CMU-CREATE-Lab/breathecam_v4/CAD/pi_cam/testing/lockring.jpg

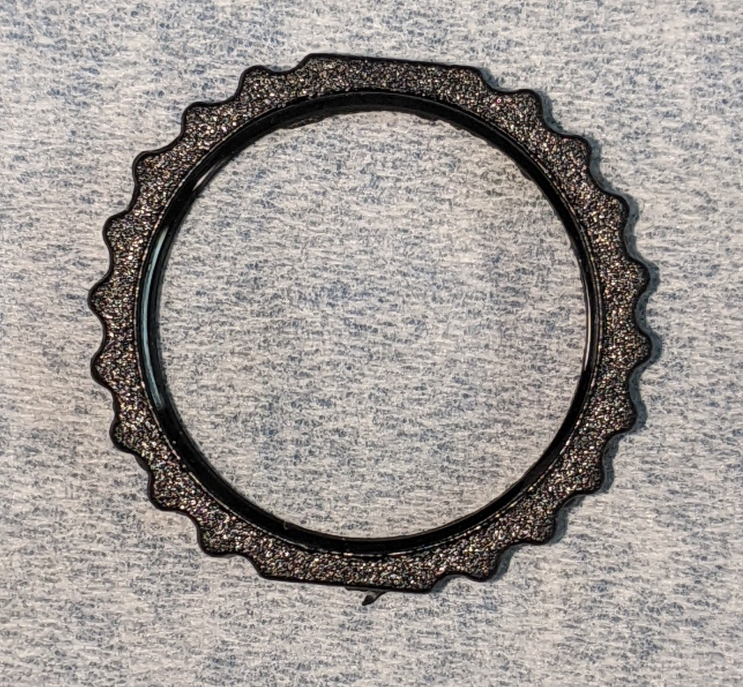
CAD/pi_cam/testing/lockring.jpg
