CMU-CREATE-Lab/breathecam_v4/README.md

See Code/pi_cam/notes.txt for info on installing and building software.
