CMU-CREATE-Lab/breathecam_v4/CAD/pi_cam/brackets/pole_clamp_assem.SLDASM

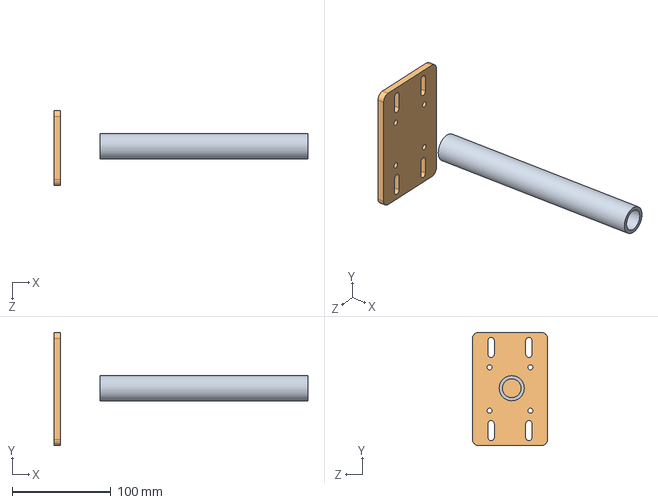
[picture p2: CAD file, 2024-10-29]
CAD/pi_cam/brackets/pole_clamp_assem.SLDASM
256.7 x 114.3 x 76.2 mm
pole_clamp_plate
dual_mount_horizontal_tube
