CMU-CREATE-Lab/breathecam_v4/CAD/pi_cam/testing/focus_adapter_14mm_assem.SLDASM

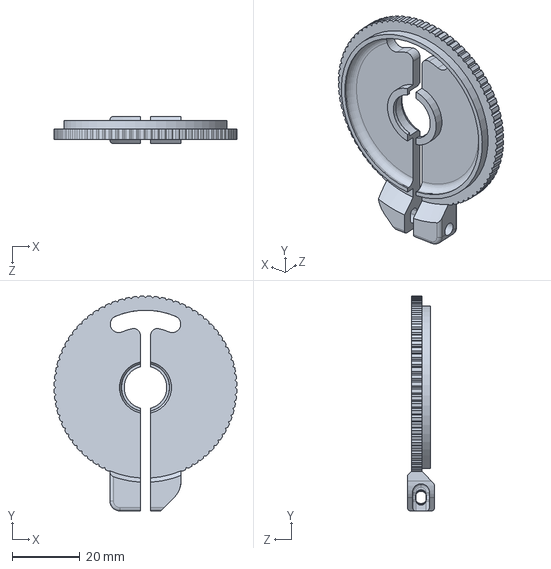
[picture p3: CAD file, 2024-01-23]
CAD/pi_cam/testing/focus_adapter_14mm_assem.SLDASM
54.0 x 63.5 x 8.00 mm
