CMU-CREATE-Lab/breathecam_v4/CAD/pi_cam/angle_fix_assy.SLDASM

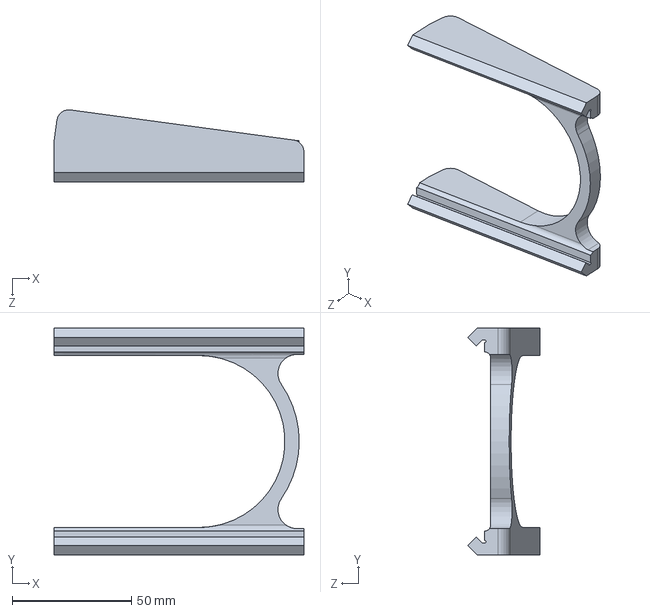
[picture p4: CAD file, 2023-10-27]
CAD/pi_cam/angle_fix_assy.SLDASM
104.8 x 95.0 x 30.3 mm
