CMU-CREATE-Lab/breathecam_v4/CAD/pi_cam/fan_assy.SLDASM

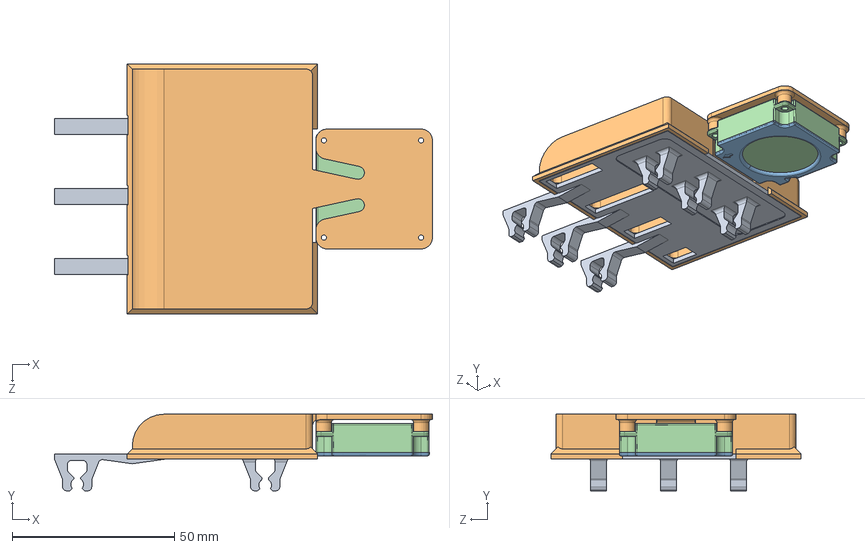
[picture p5: CAD file, 2023-10-27]
CAD/pi_cam/fan_assy.SLDASM
116.6 x 23.6 x 77.2 mm
air_box
air_top
410020620000_2.stp
3_5CM-FRAME_BEFORE__AF1.stp
