CMU-CREATE-Lab/breathecam_v4/CAD/pi_cam/brackets/flat_mount_plate_24in.SLDPRT

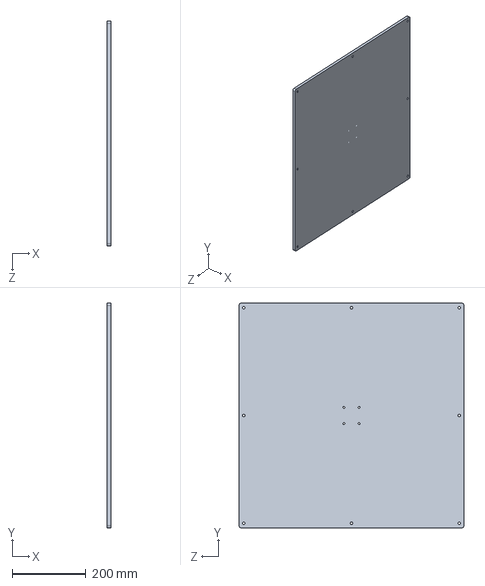
[picture p6: CAD file, 2025-08-26]
CAD/pi_cam/brackets/flat_mount_plate_24in.SLDPRT
9.53 x 609.6 x 609.6 mm
