CMU-CREATE-Lab/breathecam_v4/CAD/pi_cam/dummy_parts/CIL100-F3.6-M12ANIR.stp

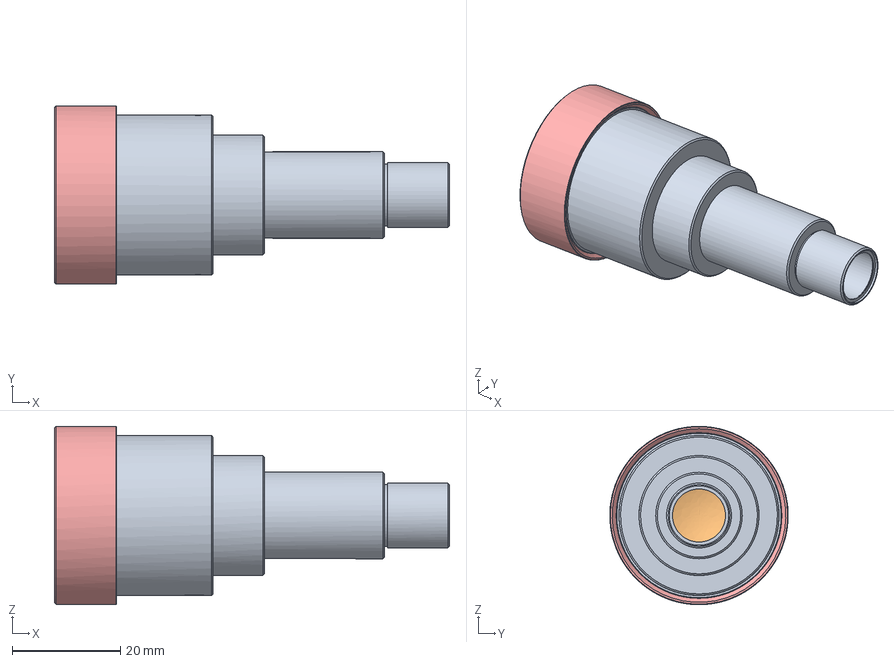
[picture p7: CAD file, 2026-09-17]
CAD/pi_cam/dummy_parts/CIL100-F3.6-M12ANIR.stp
73.0 x 33.0 x 33.0 mm
主镜筒
D-3
麦拉片
A
压圈
