CMU-CREATE-Lab/breathecam_v4/CAD/pi_cam/mount_plate_single.SLDPRT

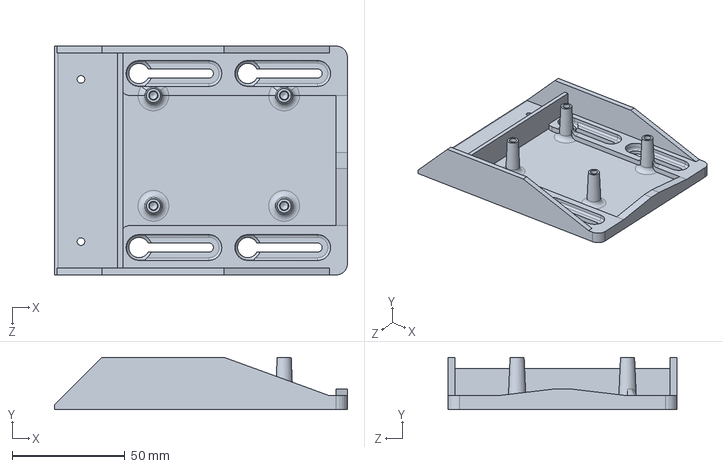
[picture p8: CAD file, 2026-09-17]
CAD/pi_cam/mount_plate_single.SLDPRT
130.0 x 23.2 x 101.6 mm
