CMU-CREATE-Lab/breathecam_v4/CAD/pi_cam/testing/focus_adapter_14mm_small.SLDPRT

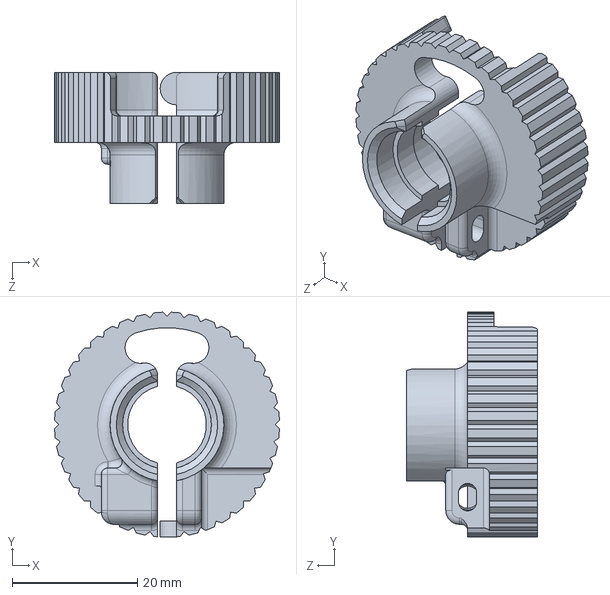
[picture p9: CAD file, 2024-10-29]
CAD/pi_cam/testing/focus_adapter_14mm_small.SLDPRT
36.0 x 35.9 x 21.0 mm
