CMU-CREATE-Lab/breathecam_v4/CAD/pi_cam/brackets/pole_clamp_plate.SLDPRT

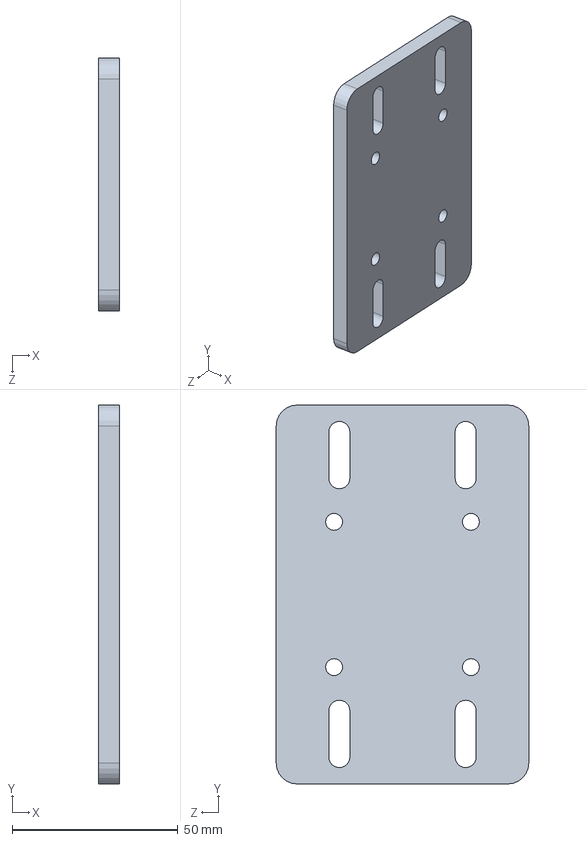
[picture p10: CAD file, 2025-05-12]
CAD/pi_cam/brackets/pole_clamp_plate.SLDPRT
6.35 x 114.3 x 76.2 mm
