CMU-CREATE-Lab/breathecam_v4/CAD/pi_cam/testing/lockring_wrench.SLDPRT

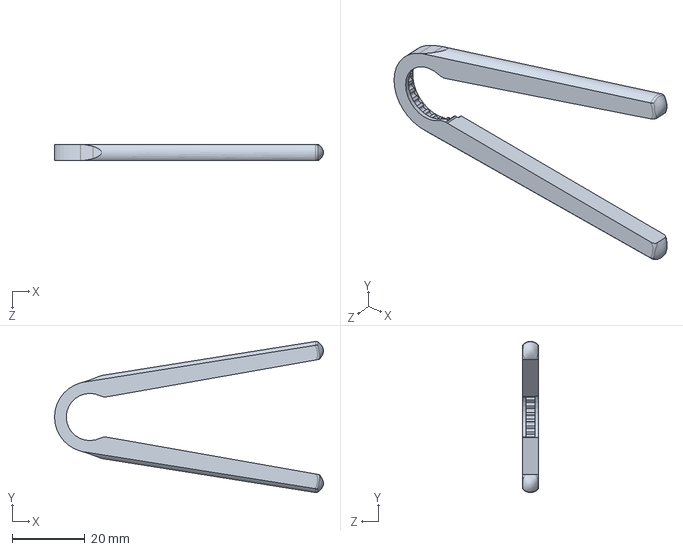
[picture p11: CAD file, 2024-10-29]
CAD/pi_cam/testing/lockring_wrench.SLDPRT
74.2 x 41.7 x 4.50 mm
