CMU-CREATE-Lab/breathecam_v4/CAD/pi_cam/brackets/flat_mount_plate.SLDPRT

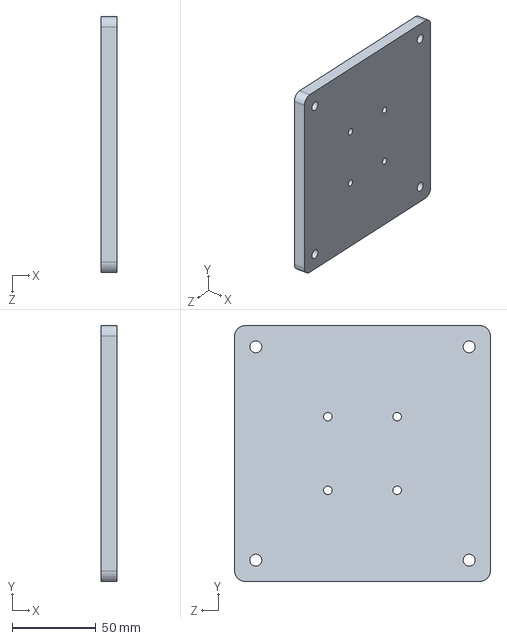
[picture p12: CAD file, 2025-05-12]
CAD/pi_cam/brackets/flat_mount_plate.SLDPRT
9.53 x 152.4 x 152.4 mm
