CMU-CREATE-Lab/breathecam_v4/CAD/pi_cam/mount_plate_single_hq_cam.SLDPRT

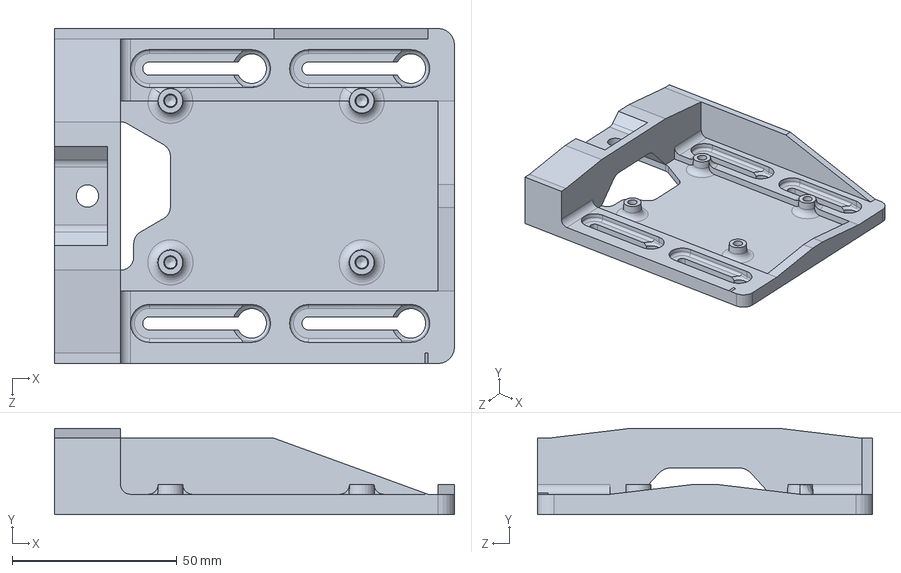
[picture p13: CAD file, 2026-09-17]
CAD/pi_cam/mount_plate_single_hq_cam.SLDPRT
121.2 x 26.2 x 101.6 mm
