CMU-CREATE-Lab/breathecam_v4/CAD/pi_cam/testing/test_mount_plate_clamp.SLDPRT

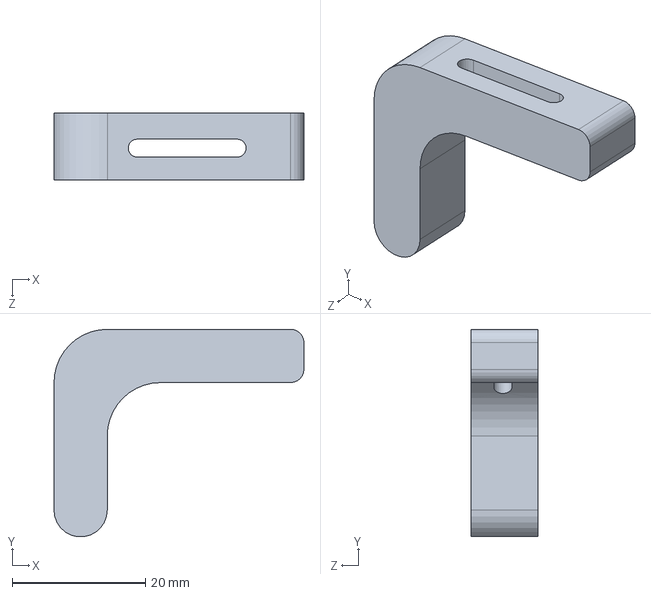
[picture p14: CAD file, 2024-10-29]
CAD/pi_cam/testing/test_mount_plate_clamp.SLDPRT
37.5 x 31.1 x 10.0 mm
