CMU-CREATE-Lab/breathecam_v4/CAD/pi_cam/camera_mount_hq_single.SLDPRT

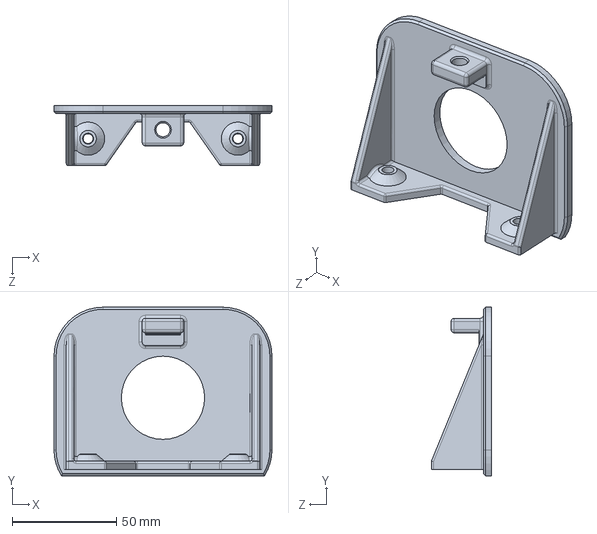
[picture p15: CAD file, 2026-09-17]
CAD/pi_cam/camera_mount_hq_single.SLDPRT
104.8 x 81.0 x 29.0 mm
