CMU-CREATE-Lab/breathecam_v4/CAD/pi_cam/testing/test_mount_plate.SLDPRT

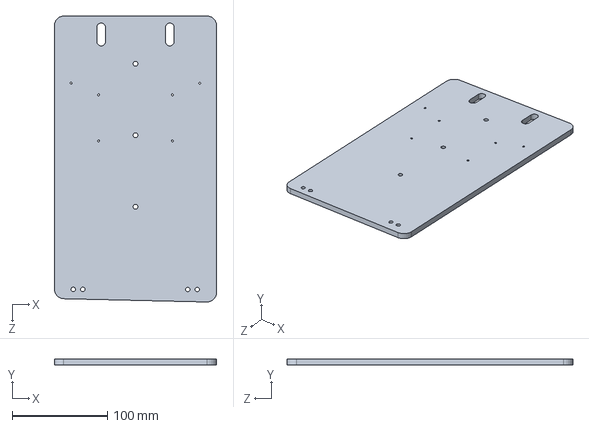
[picture p16: CAD file, 2024-10-29]
CAD/pi_cam/testing/test_mount_plate.SLDPRT
170.0 x 6.35 x 299.8 mm
