CMU-CREATE-Lab/breathecam_v4/CAD/pi_cam/testing/focus_adapter_clamp2.SLDPRT

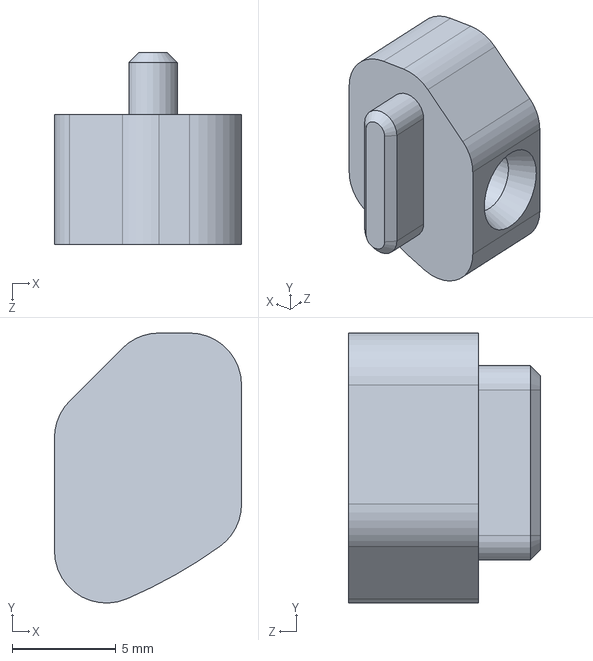
[picture p17: CAD file, 2024-01-23]
CAD/pi_cam/testing/focus_adapter_clamp2.SLDPRT
9.00 x 13.0 x 9.25 mm
