CMU-CREATE-Lab/breathecam_v4/CAD/pi_cam/brackets/quick_connect_adapter.SLDPRT

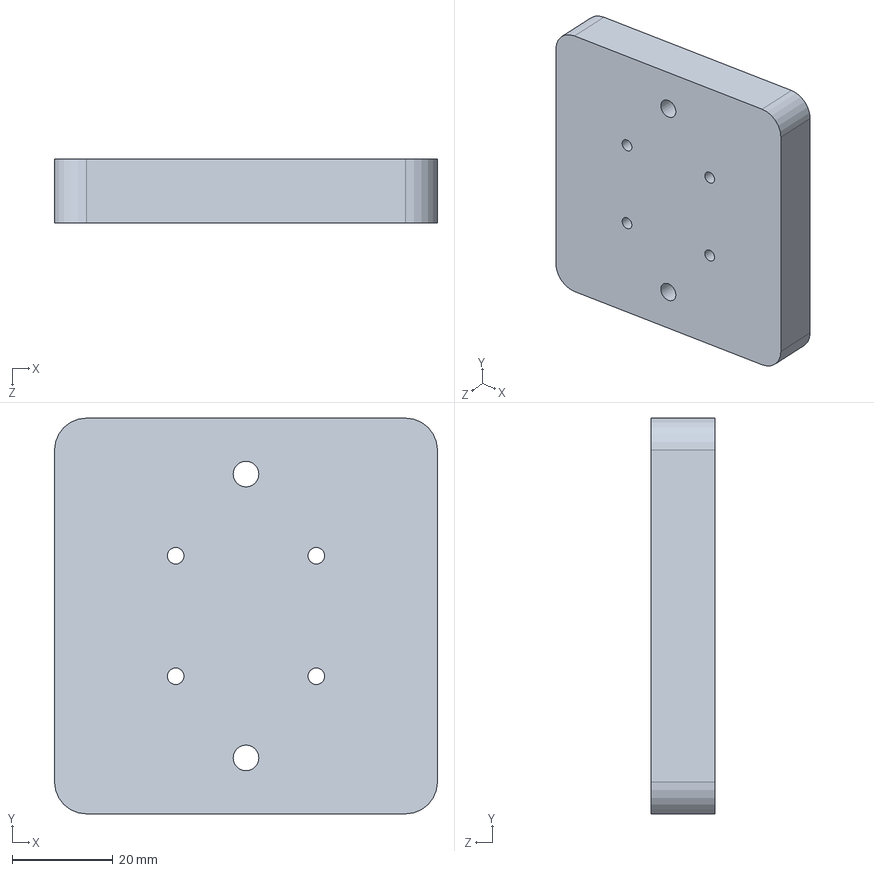
[picture p18: CAD file, 2024-03-25]
CAD/pi_cam/brackets/quick_connect_adapter.SLDPRT
76.2 x 78.7 x 12.7 mm
