CMU-CREATE-Lab/breathecam_v4/CAD/pi_cam/camera_mount_4x1_portrait_16mm_al_v4.SLDPRT

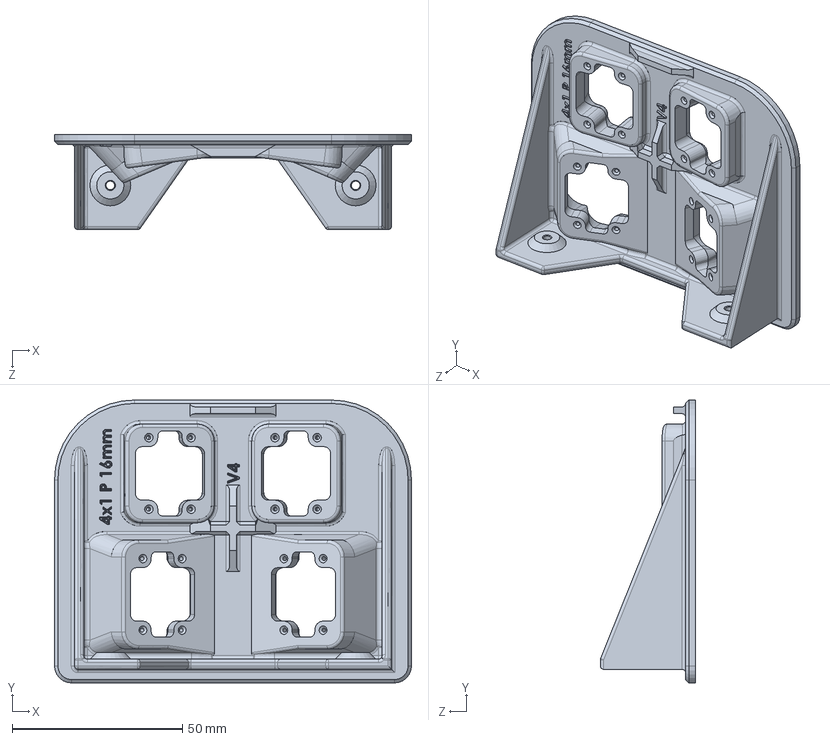
[picture p19: CAD file, 2024-10-29]
CAD/pi_cam/camera_mount_4x1_portrait_16mm_al_v4.SLDPRT
104.8 x 83.0 x 28.0 mm
