CMU-CREATE-Lab/breathecam_v4/CAD/pi_cam/testing/focus_adapter_clamp1.SLDPRT

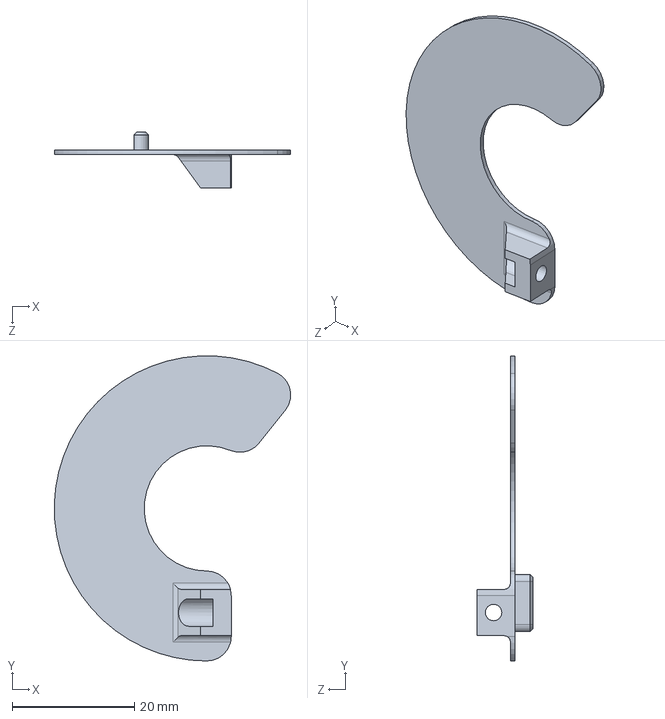
[picture p20: CAD file, 2024-01-23]
CAD/pi_cam/testing/focus_adapter_clamp1.SLDPRT
38.7 x 50.0 x 9.25 mm
