CMU-CREATE-Lab/breathecam_v4/CAD/pi_cam/brackets/pole_18in.SLDPRT

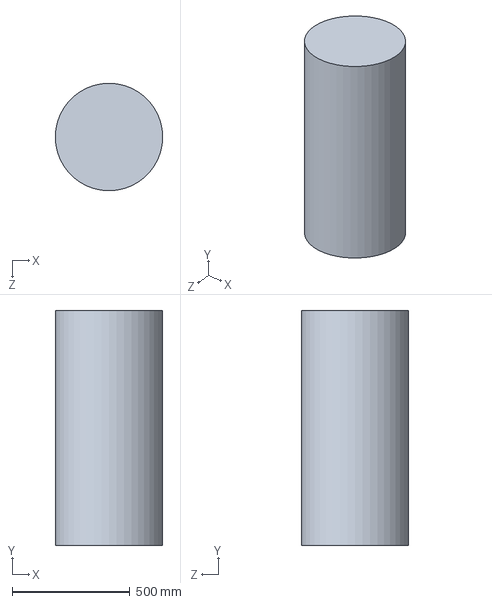
[picture p21: CAD file, 2023-10-27]
CAD/pi_cam/brackets/pole_18in.SLDPRT
457.2 x 1000.0 x 457.2 mm
