CMU-CREATE-Lab/breathecam_v4/CAD/pi_cam/camera_cap_fat_clearance.SLDPRT

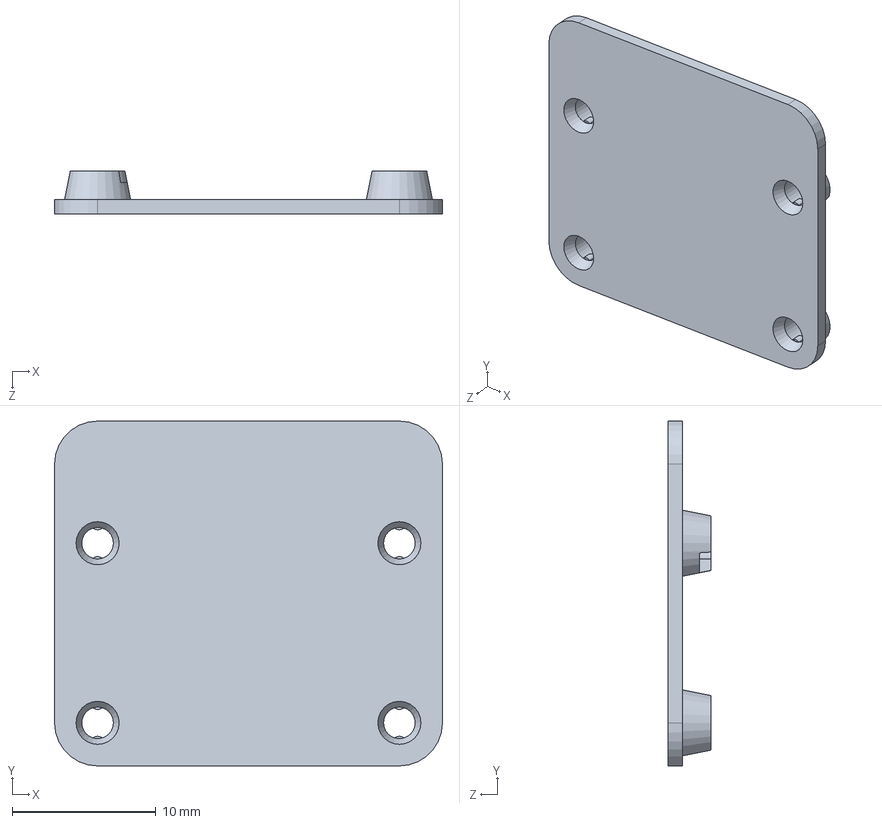
[picture p22: CAD file, 2024-10-29]
CAD/pi_cam/camera_cap_fat_clearance.SLDPRT
27.0 x 24.0 x 3.00 mm
