CMU-CREATE-Lab/breathecam_v4/CAD/pi_cam/brackets/dual_mount_horizontal_tube.SLDPRT

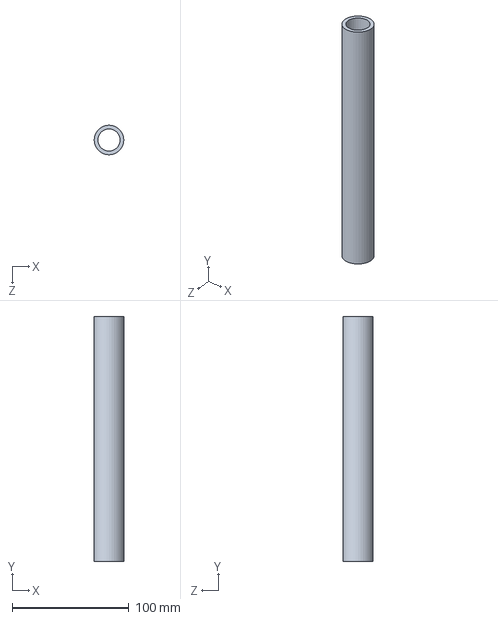
[picture p23: CAD file, 2023-10-27]
CAD/pi_cam/brackets/dual_mount_horizontal_tube.SLDPRT
25.4 x 210.0 x 25.4 mm
