CMU-CREATE-Lab/breathecam_v4/CAD/pi_cam/testing/camera_retainer.SLDPRT

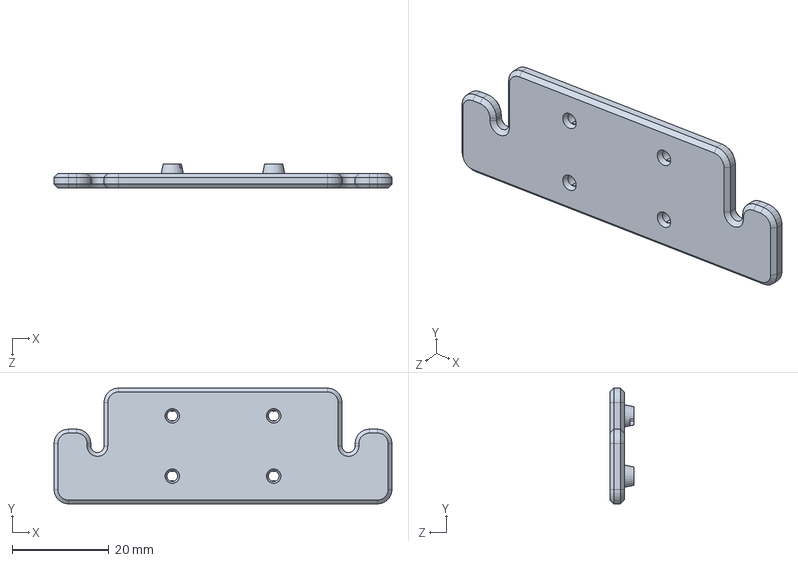
[picture p24: CAD file, 2024-01-23]
CAD/pi_cam/testing/camera_retainer.SLDPRT
70.0 x 24.0 x 5.00 mm
