CMU-CREATE-Lab/breathecam_v4/CAD/pi_cam/brackets/pole_mount_spacer.SLDPRT

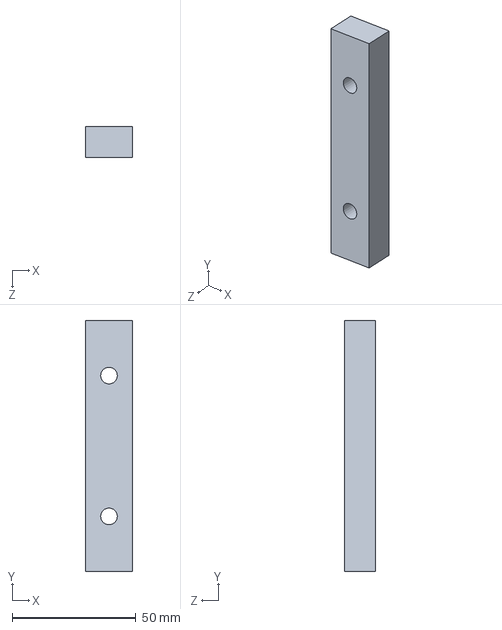
[picture p25: CAD file, 2023-10-27]
CAD/pi_cam/brackets/pole_mount_spacer.SLDPRT
19.1 x 101.6 x 12.7 mm
