CMU-CREATE-Lab/breathecam_v4/CAD/pi_cam/camera_mount_4x1_portrait_12mm_al.SLDPRT

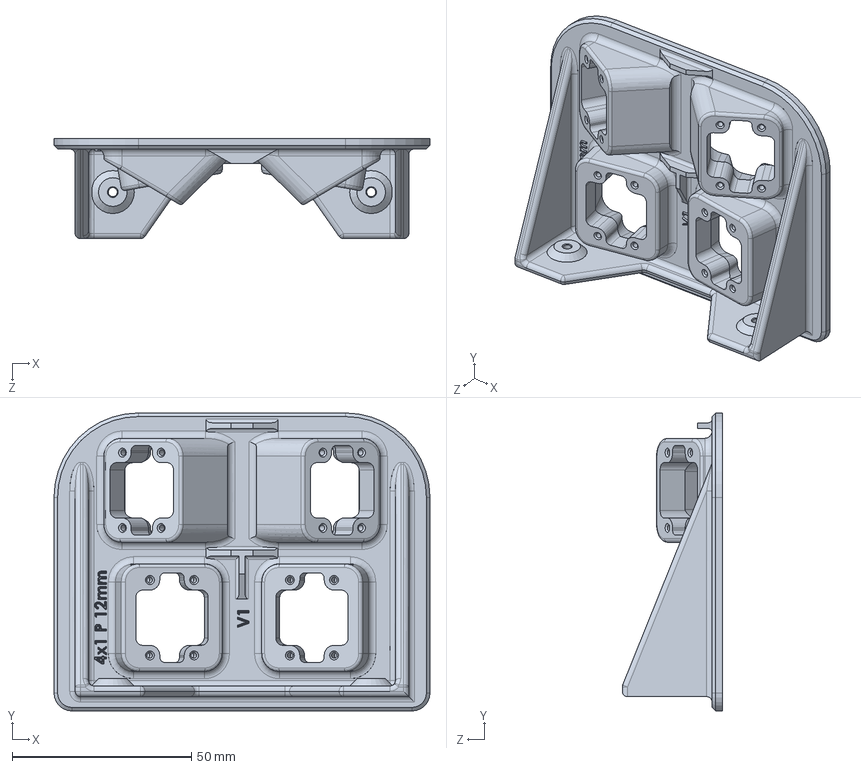
[picture p26: CAD file, 2024-01-23]
CAD/pi_cam/camera_mount_4x1_portrait_12mm_al.SLDPRT
104.8 x 83.0 x 28.0 mm
