CMU-CREATE-Lab/breathecam_v4/CAD/pi_cam/angle_fix_4x1_16mm_p_bot.3mf

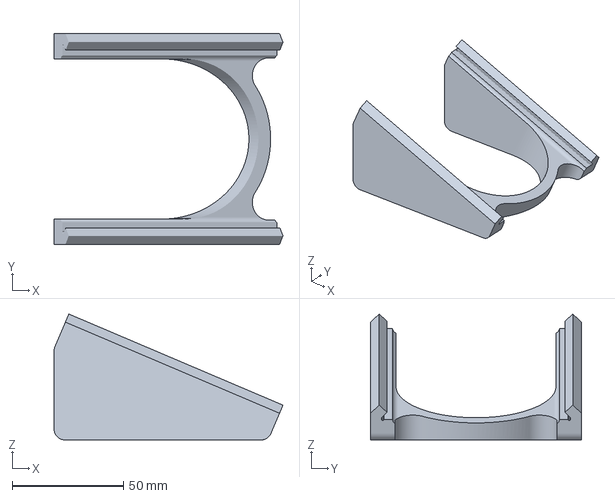
[picture p27: CAD file, 2023-11-29]
CAD/pi_cam/angle_fix_4x1_16mm_p_bot.3mf
103.1 x 95.0 x 56.7 mm
