CMU-CREATE-Lab/breathecam_v4/CAD/pi_cam/brackets/dual_mount_vertical_tube.SLDPRT

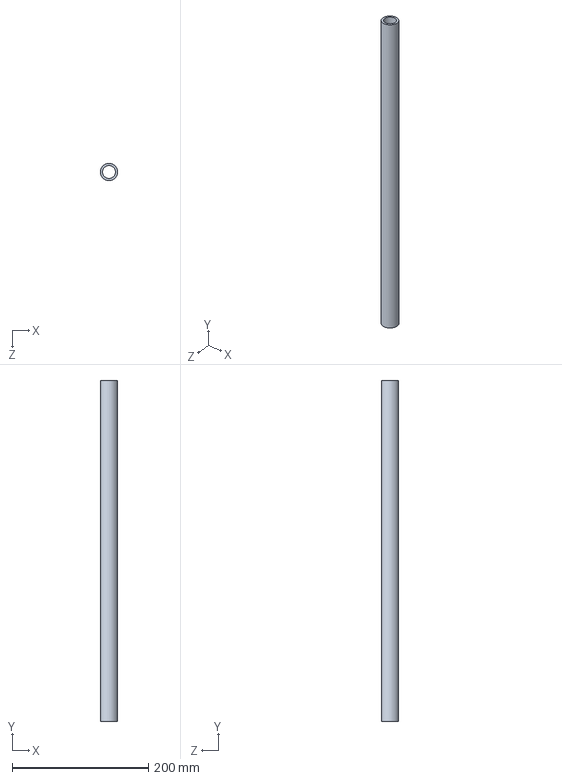
[picture p28: CAD file, 2023-10-27]
CAD/pi_cam/brackets/dual_mount_vertical_tube.SLDPRT
25.3 x 500.0 x 25.4 mm
