CMU-CREATE-Lab/breathecam_v4/CAD/pi_cam/testing/camera_mount_test.SLDPRT

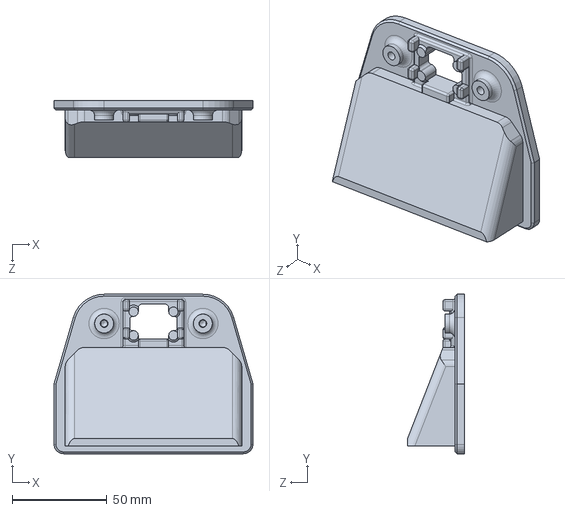
[picture p29: CAD file, 2023-12-06]
CAD/pi_cam/testing/camera_mount_test.SLDPRT
104.8 x 84.0 x 30.0 mm
