CMU-CREATE-Lab/breathecam_v4/CAD/pi_cam/drill_guide.SLDPRT

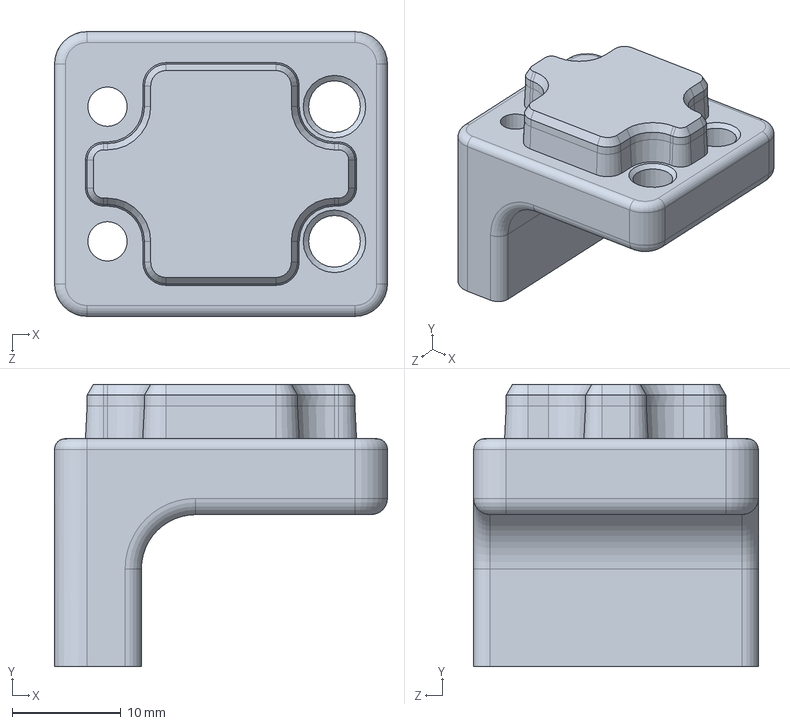
[picture p30: CAD file, 2023-11-01]
CAD/pi_cam/drill_guide.SLDPRT
30.7 x 26.0 x 26.2 mm
