CMU-CREATE-Lab/breathecam_v4/CAD/pi_cam/testing/target_guide.SLDPRT

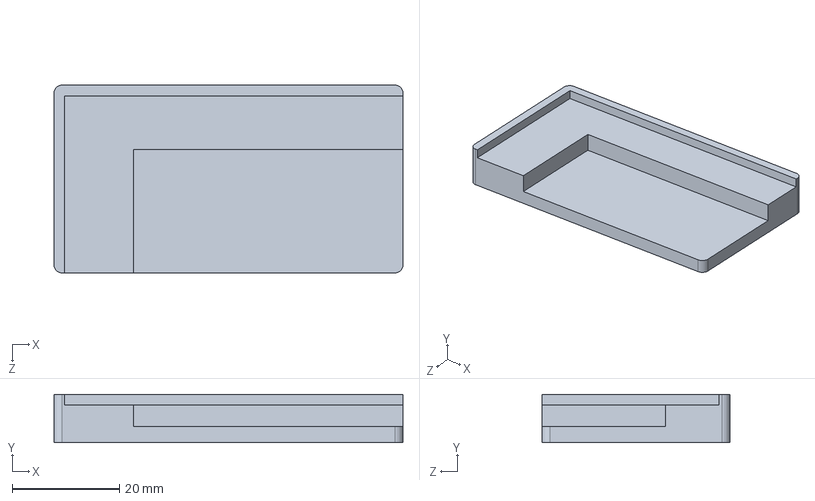
[picture p31: CAD file, 2023-12-06]
CAD/pi_cam/testing/target_guide.SLDPRT
65.0 x 9.00 x 35.0 mm
