CMU-CREATE-Lab/breathecam_v4/CAD/pi_cam/dummy_parts/anker_atom_slim.SLDPRT

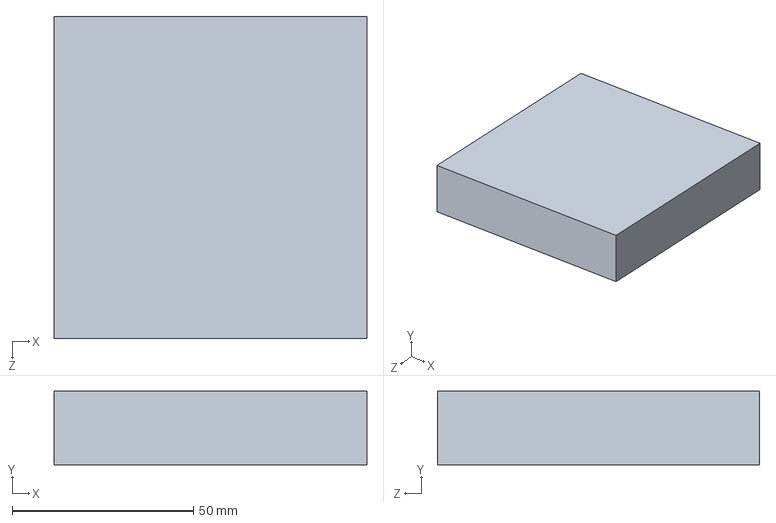
[picture p32: CAD file, 2023-10-27]
CAD/pi_cam/dummy_parts/anker_atom_slim.SLDPRT
86.4 x 20.3 x 88.9 mm
