CMU-CREATE-Lab/breathecam_v4/CAD/pi_cam/camera_insulator.SLDPRT

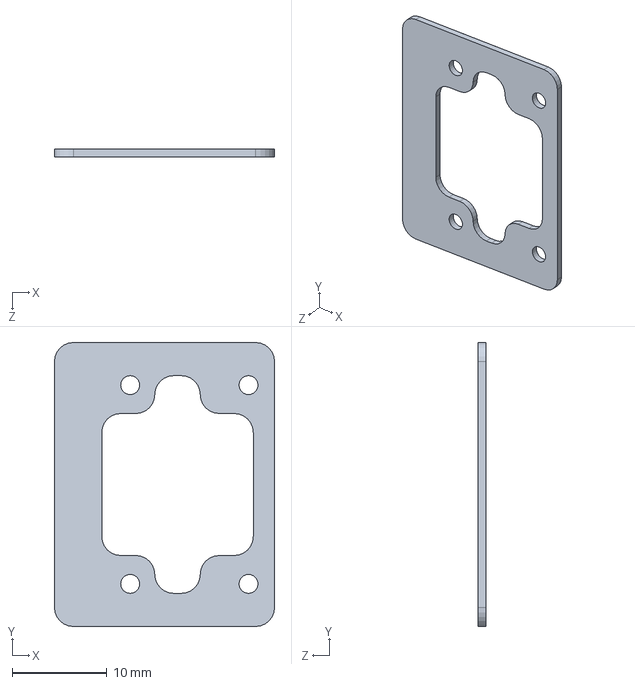
[picture p33: CAD file, 2023-10-27]
CAD/pi_cam/camera_insulator.SLDPRT
23.2 x 30.0 x 0.8 mm
