CMU-CREATE-Lab/breathecam_v4/CAD/pi_cam/dummy_parts/pelco_eh20_external.SLDPRT

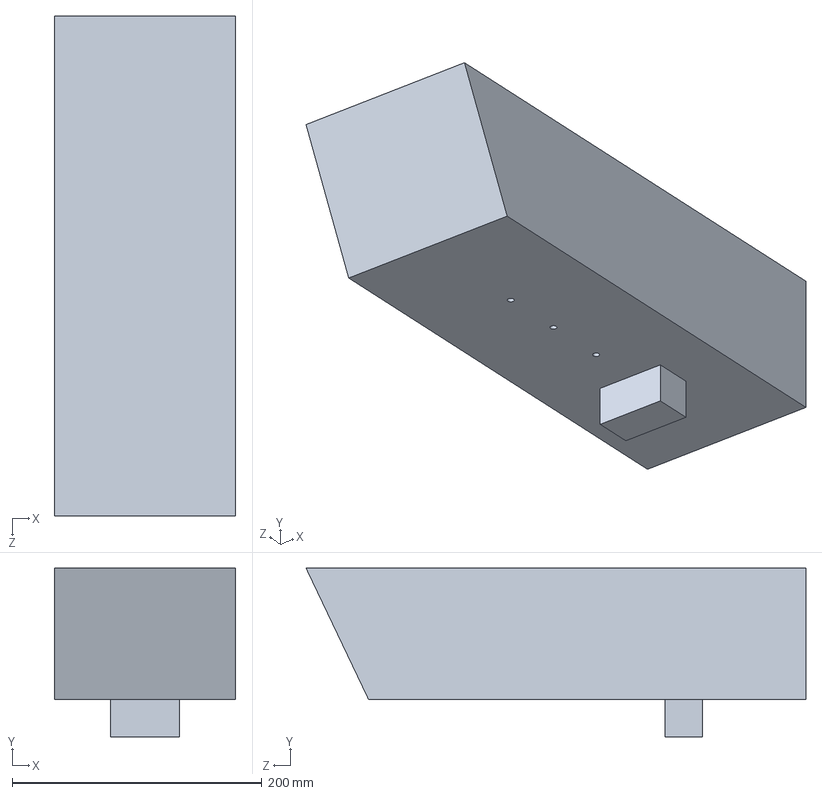
[picture p34: CAD file, 2023-10-27]
CAD/pi_cam/dummy_parts/pelco_eh20_external.SLDPRT
145.0 x 135.0 x 400.0 mm
