CMU-CREATE-Lab/breathecam_v4/CAD/pi_cam/testing/glass_holder_3in.SLDPRT

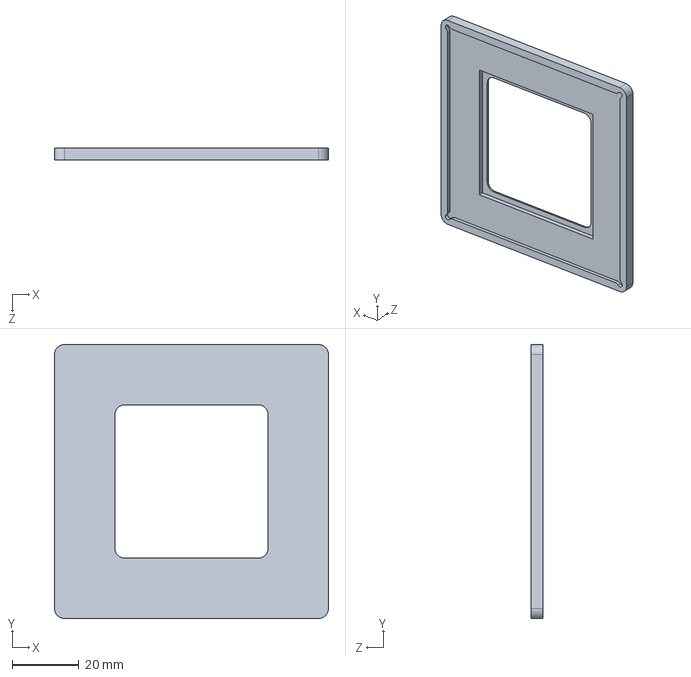
[picture p35: CAD file, 2023-11-29]
CAD/pi_cam/testing/glass_holder_3in.SLDPRT
82.2 x 82.2 x 3.60 mm
