CMU-CREATE-Lab/breathecam_v4/CAD/pi_cam/mount_plate_4pi.SLDPRT

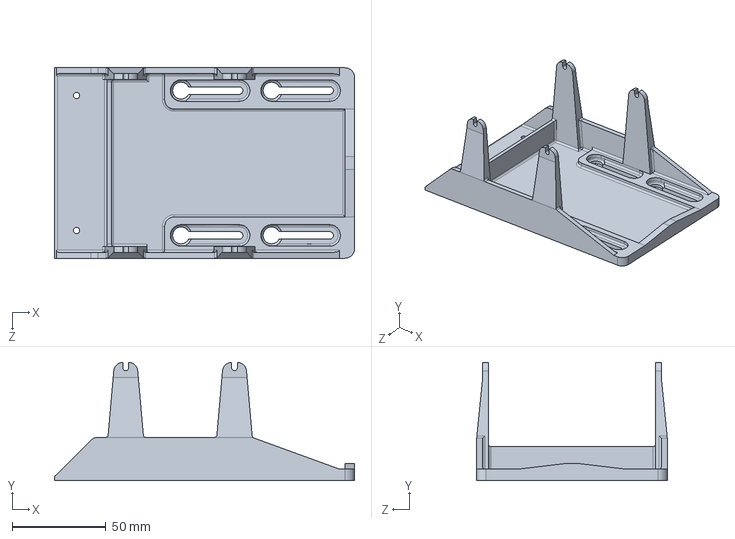
[picture p36: CAD file, 2023-10-27]
CAD/pi_cam/mount_plate_4pi.SLDPRT
160.0 x 63.2 x 101.6 mm
