CMU-CREATE-Lab/breathecam_v4/CAD/pi_cam/testing/spacer_block.SLDPRT

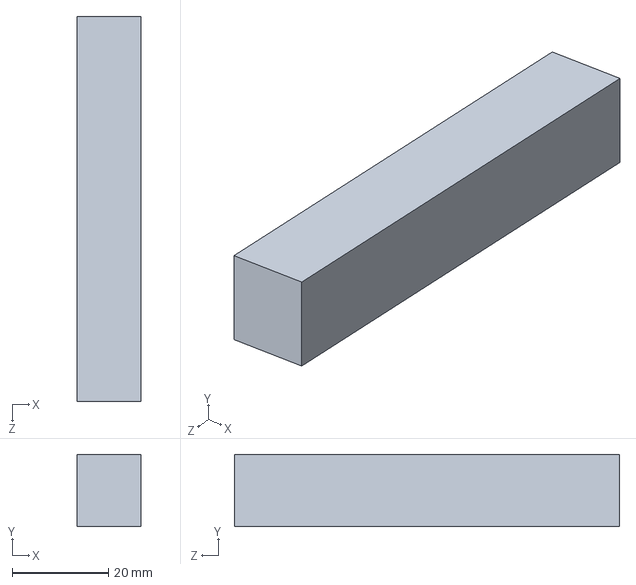
[picture p37: CAD file, 2023-11-29]
CAD/pi_cam/testing/spacer_block.SLDPRT
13.3 x 15.0 x 80.0 mm
