CMU-CREATE-Lab/breathecam_v4/CAD/pi_cam/air_box.SLDPRT

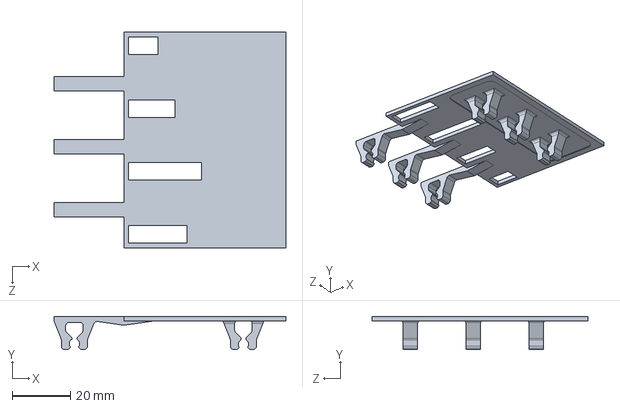
[picture p38: CAD file, 2023-10-27]
CAD/pi_cam/air_box.SLDPRT
79.6 x 11.4 x 74.0 mm
