CMU-CREATE-Lab/breathecam_v4/CAD/pi_cam/dummy_parts/pelco_eh20.SLDPRT

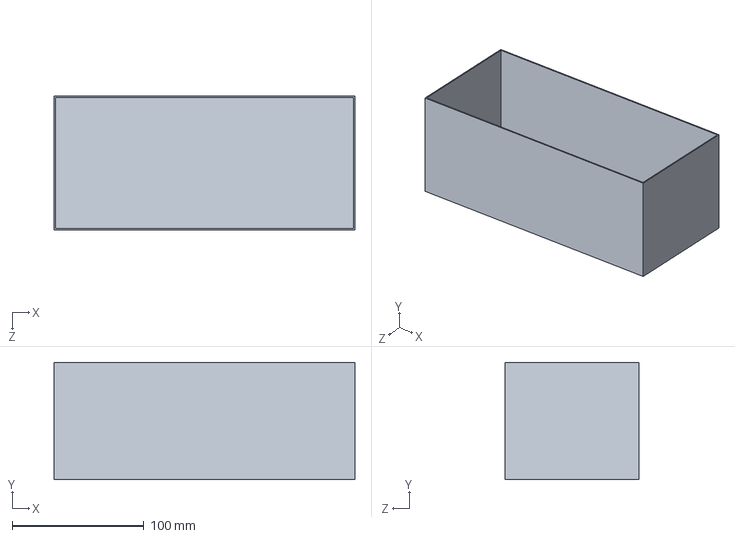
[picture p39: CAD file, 2023-10-27]
CAD/pi_cam/dummy_parts/pelco_eh20.SLDPRT
228.6 x 88.9 x 101.6 mm
