CMU-CREATE-Lab/breathecam_v4/CAD/pi_cam/air_top.SLDPRT

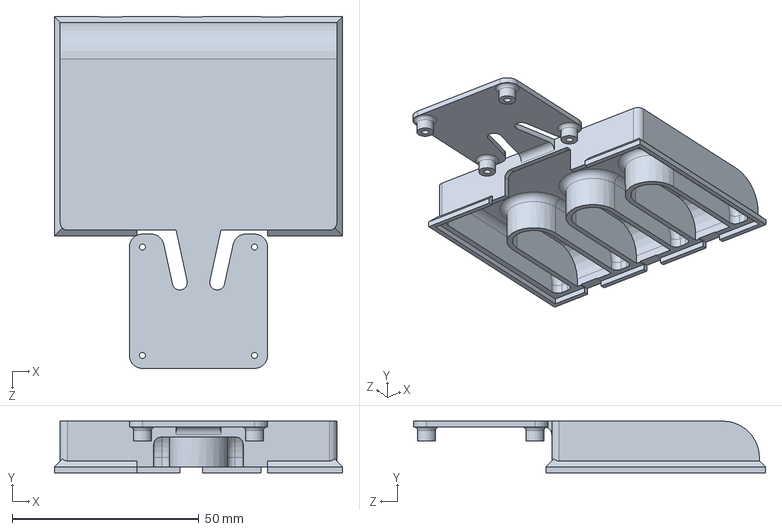
[picture p40: CAD file, 2023-10-27]
CAD/pi_cam/air_top.SLDPRT
77.2 x 13.9 x 94.2 mm
