CMU-CREATE-Lab/breathecam_v4/CAD/pi_cam/dummy_parts/netgear_gs305.SLDPRT

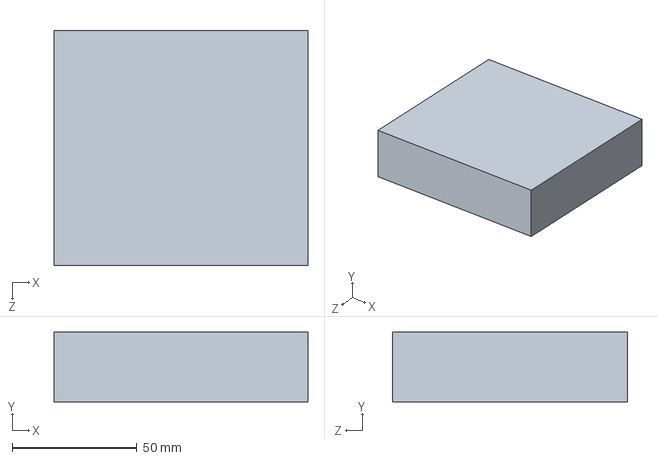
[picture p41: CAD file, 2023-10-27]
CAD/pi_cam/dummy_parts/netgear_gs305.SLDPRT
101.6 x 27.9 x 94.0 mm
