CMU-CREATE-Lab/breathecam_v4/CAD/pi_cam/testing/lens_threading_guide.SLDPRT

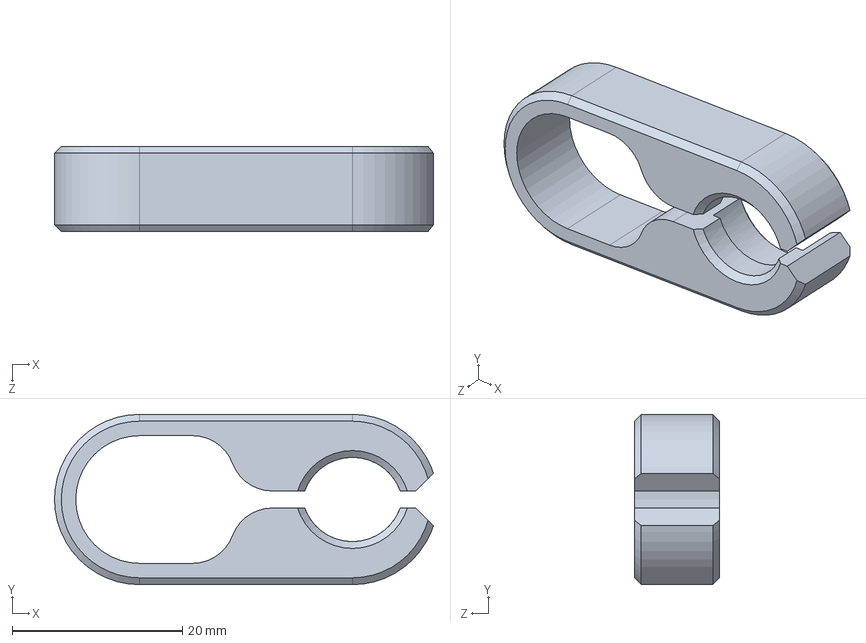
[picture p42: CAD file, 2023-11-29]
CAD/pi_cam/testing/lens_threading_guide.SLDPRT
44.5 x 20.0 x 10.0 mm
