CMU-CREATE-Lab/breathecam_v4/CAD/pi_cam/testing/lens_lock.SLDPRT

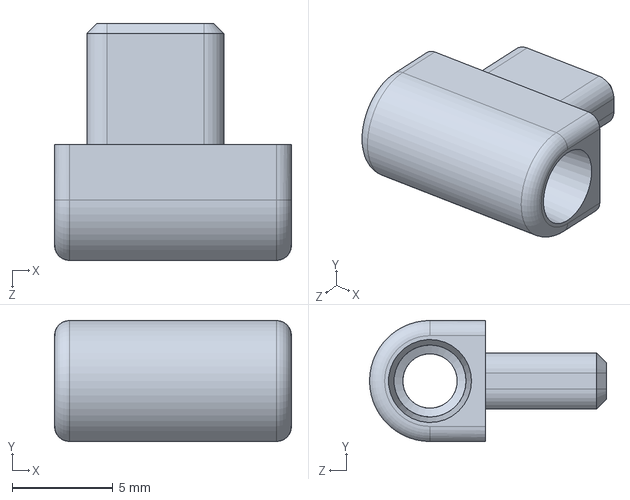
[picture p44: CAD file, 2023-11-29]
CAD/pi_cam/testing/lens_lock.SLDPRT
11.8 x 6.00 x 11.8 mm
