CMU-CREATE-Lab/breathecam_v4/CAD/pi_cam/testing/target_clamp.SLDPRT

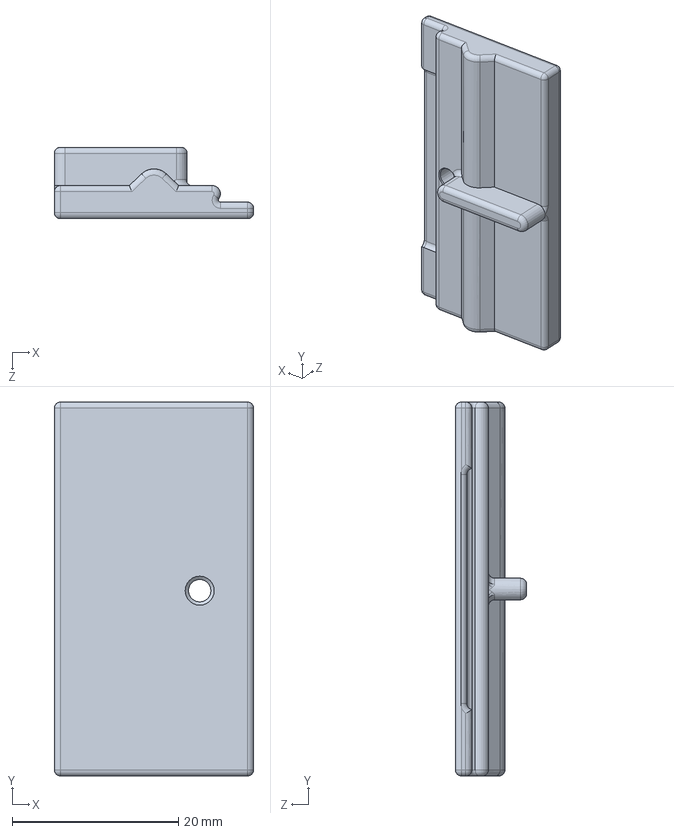
[picture p45: CAD file, 2023-11-29]
CAD/pi_cam/testing/target_clamp.SLDPRT
24.0 x 45.0 x 8.60 mm
