CMU-CREATE-Lab/breathecam_v4/CAD/pi_cam/dummy_parts/m25_short_rod.SLDPRT

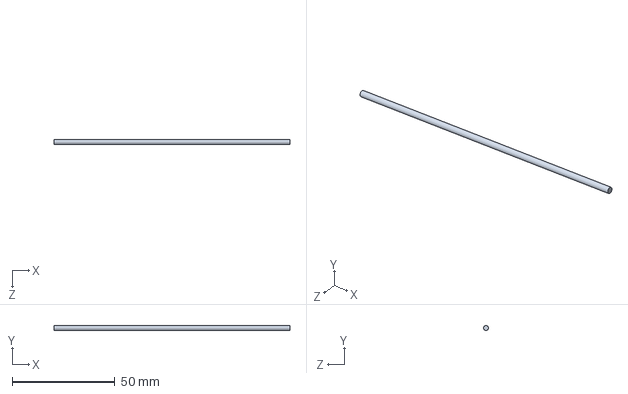
[picture p46: CAD file, 2023-10-27]
CAD/pi_cam/dummy_parts/m25_short_rod.SLDPRT
115.0 x 2.50 x 2.50 mm
