CMU-CREATE-Lab/breathecam_v4/CAD/pi_cam/testing/focus_lock.SLDPRT

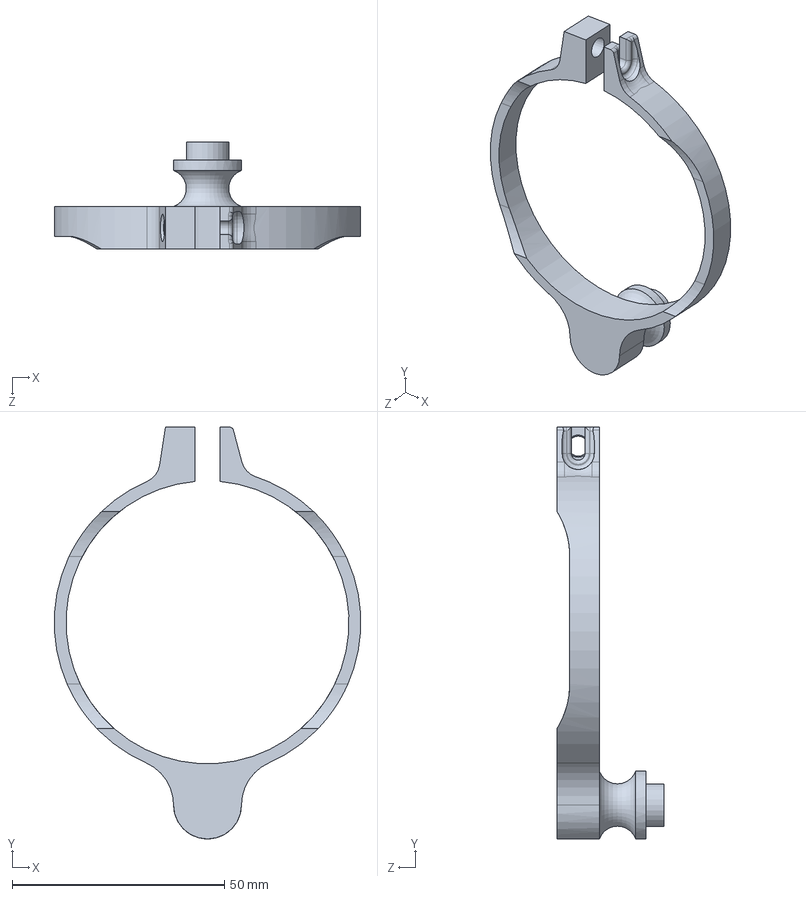
[picture p47: CAD file, 2023-11-29]
CAD/pi_cam/testing/focus_lock.SLDPRT
72.1 x 97.0 x 25.2 mm
