CMU-CREATE-Lab/breathecam_v4/CAD/pi_cam/power_mount.SLDPRT

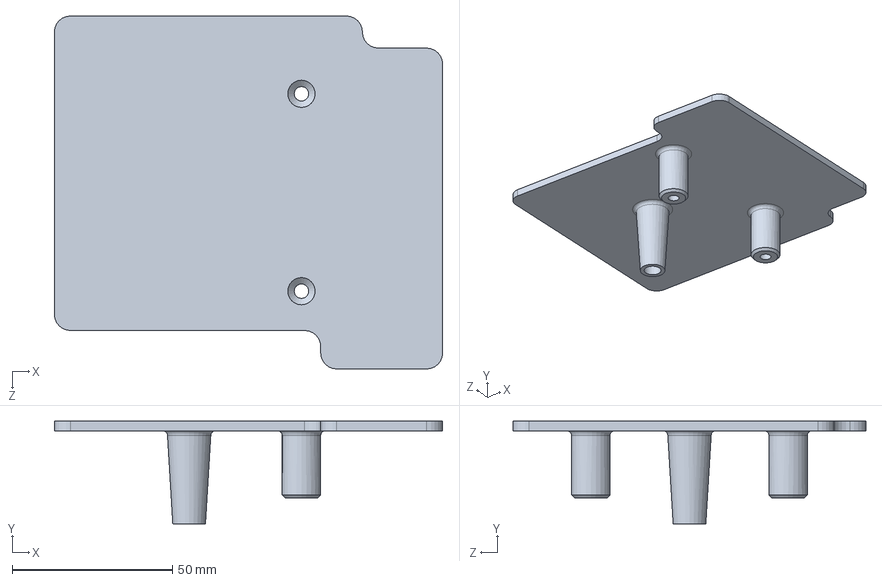
[picture p48: CAD file, 2023-10-27]
CAD/pi_cam/power_mount.SLDPRT
121.0 x 32.0 x 110.0 mm
