CMU-CREATE-Lab/breathecam_v4/CAD/pi_cam/testing/target_mount.SLDPRT

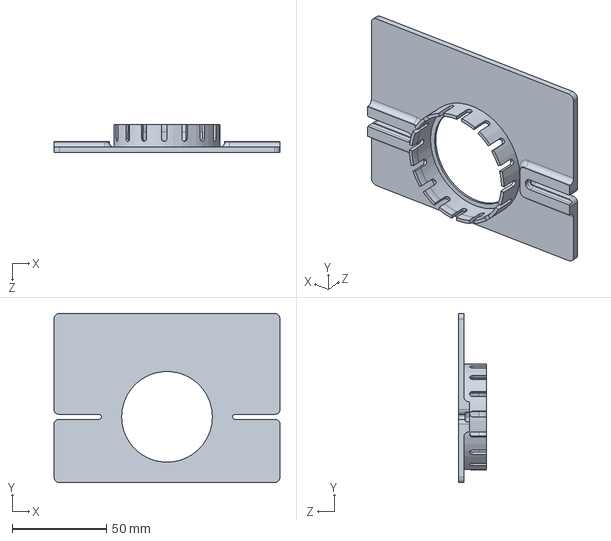
[picture p49: CAD file, 2023-11-29]
CAD/pi_cam/testing/target_mount.SLDPRT
120.0 x 90.0 x 15.0 mm
