CMU-CREATE-Lab/breathecam_v4/CAD/pi_cam/camera_mount_single_landscape.SLDPRT

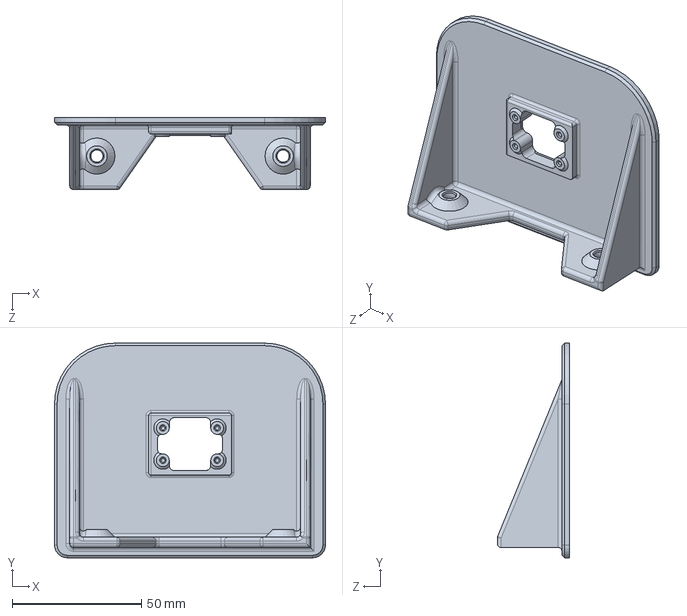
[picture p50: CAD file, 2023-08-14]
CAD/pi_cam/camera_mount_single_landscape.SLDPRT
104.8 x 83.0 x 28.0 mm
