CMU-CREATE-Lab/breathecam_v4/CAD/pi_cam/dummy_parts/Raspberry Pi HQ Camera.step

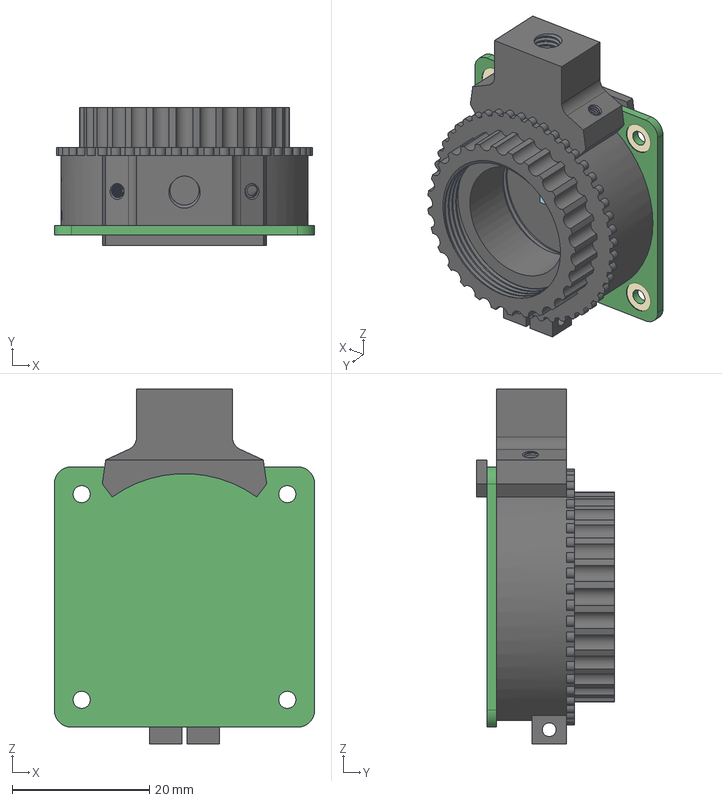
[picture p51: CAD file, 2023-02-08]
CAD/pi_cam/dummy_parts/Raspberry Pi HQ Camera.step
38.0 x 20.1 x 51.8 mm
