CMU-CREATE-Lab/breathecam_v4/CAD/pi_cam/testing/glass_holder_2in.SLDPRT

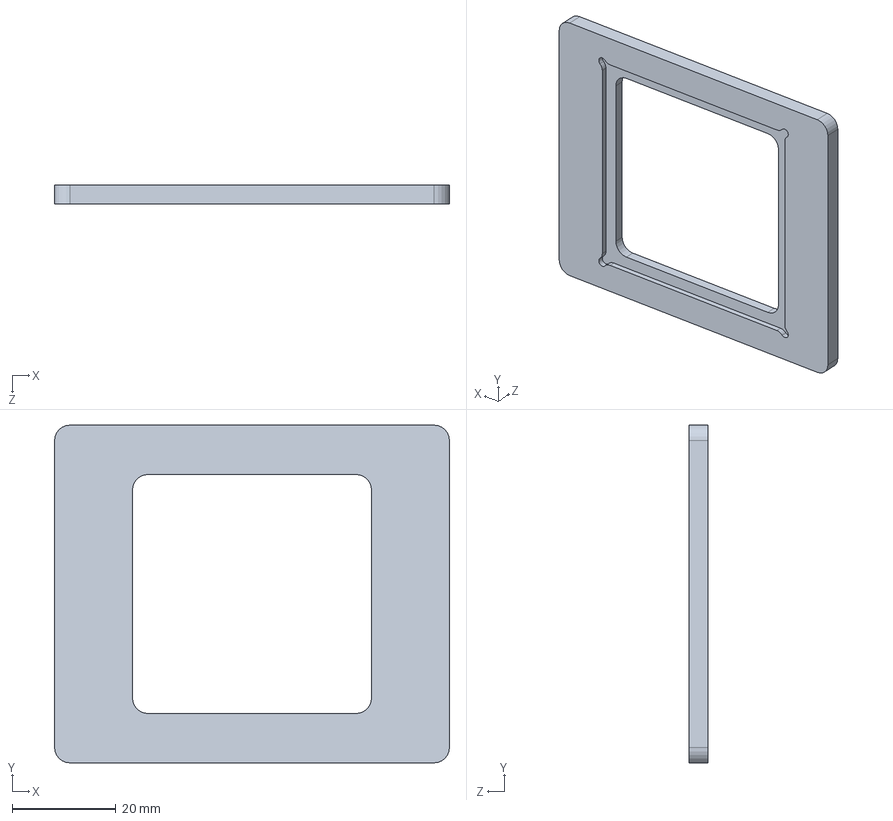
[picture p52: CAD file, 2023-11-29]
CAD/pi_cam/testing/glass_holder_2in.SLDPRT
76.0 x 65.0 x 3.60 mm
