CMU-CREATE-Lab/breathecam_v4/CAD/pi_cam/testing/centering_adapter_14mm.SLDPRT

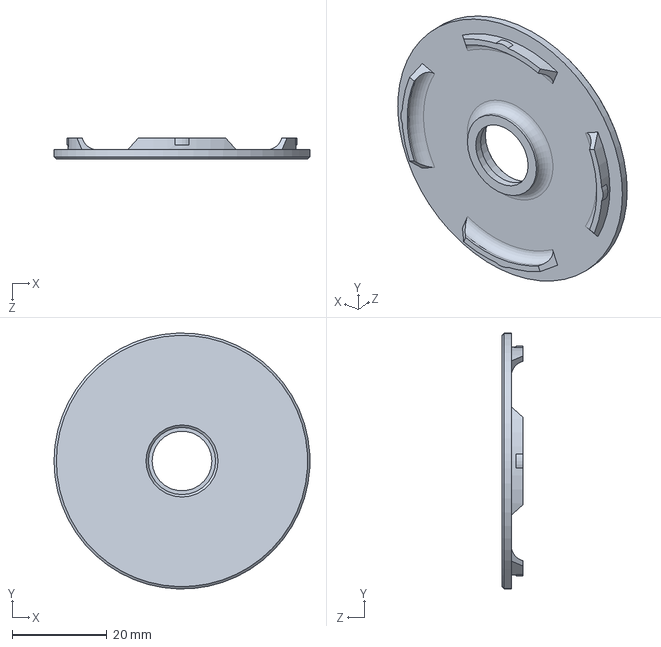
[picture p53: CAD file, 2023-06-27]
CAD/pi_cam/testing/centering_adapter_14mm.SLDPRT
54.0 x 54.0 x 4.50 mm
