CMU-CREATE-Lab/breathecam_v4/CAD/pi_cam/angle_fix_4x1_25mm_p_top.STL

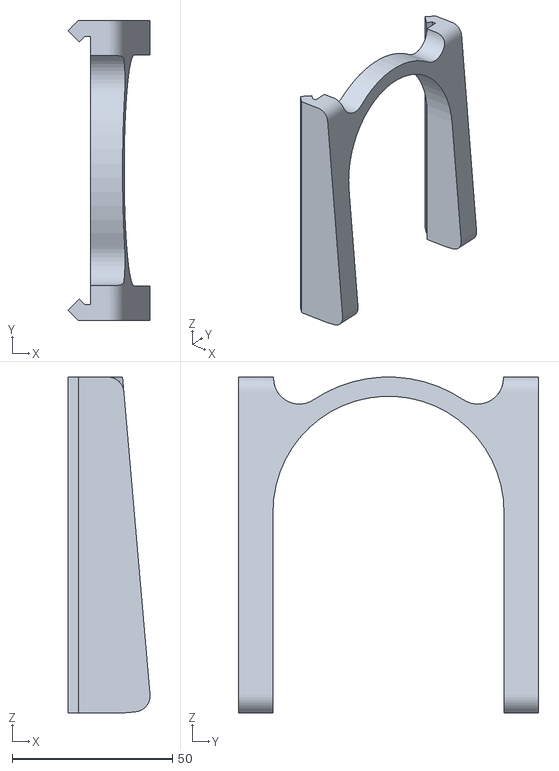
[picture p54: CAD file, 2023-08-04]
CAD/pi_cam/angle_fix_4x1_25mm_p_top.STL
25.6 x 93.6 x 104.8
