CMU-CREATE-Lab/breathecam_v4/CAD/pi_cam/testing/glass_clip.SLDPRT

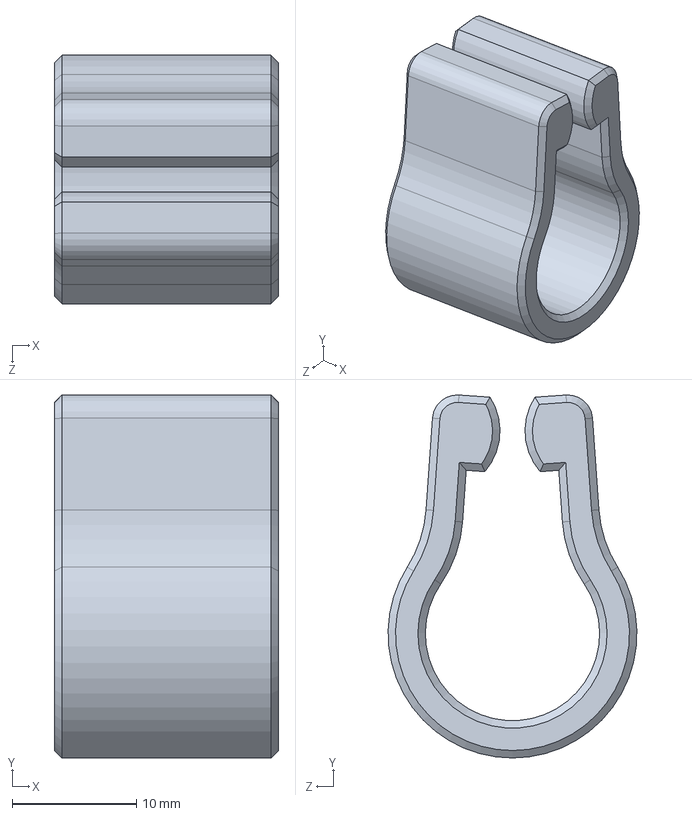
[picture p55: CAD file, 2023-06-22]
CAD/pi_cam/testing/glass_clip.SLDPRT
18.0 x 29.2 x 20.0 mm
