CMU-CREATE-Lab/breathecam_v4/CAD/pi_cam/angle_fix_4x1_25mm_p_bot.STL

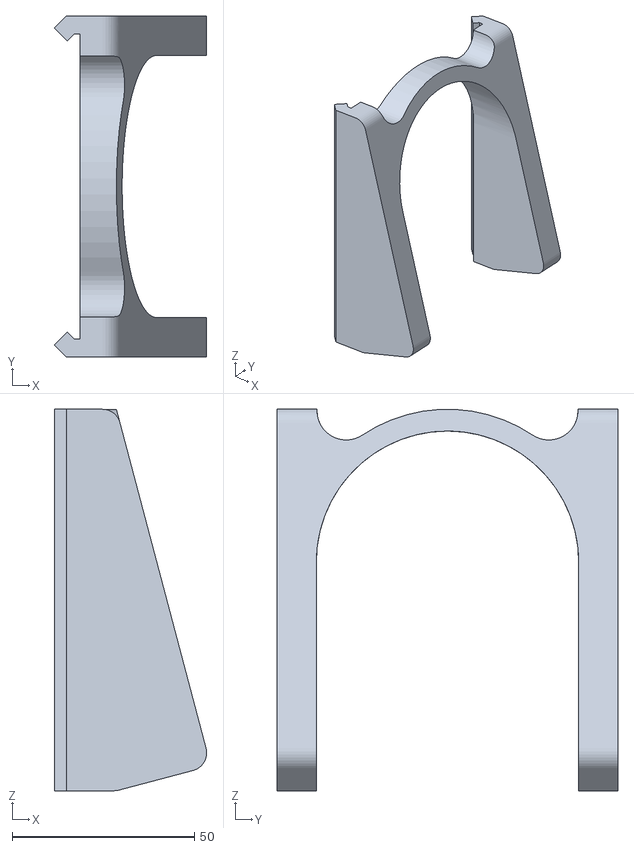
[picture p56: CAD file, 2023-08-04]
CAD/pi_cam/angle_fix_4x1_25mm_p_bot.STL
41.8 x 93.6 x 104.8
