CMU-CREATE-Lab/breathecam_v4/CAD/pi_cam/testing/microscope_mount.SLDPRT

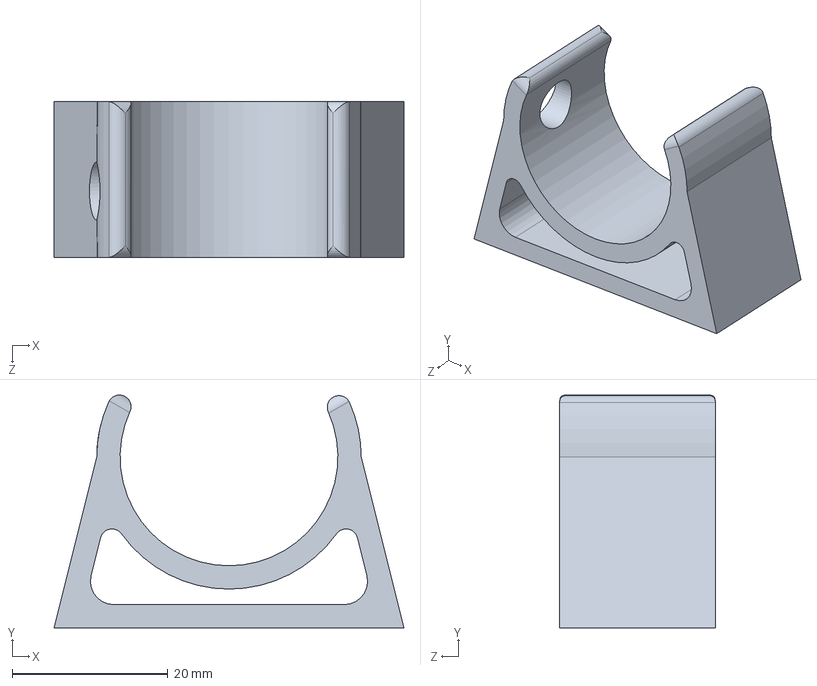
[picture p57: CAD file, 2023-06-22]
CAD/pi_cam/testing/microscope_mount.SLDPRT
45.0 x 29.9 x 20.0 mm
