CMU-CREATE-Lab/breathecam_v4/CAD/pi_cam/camera_mount_2x2_landscape_16mm_al.SLDPRT

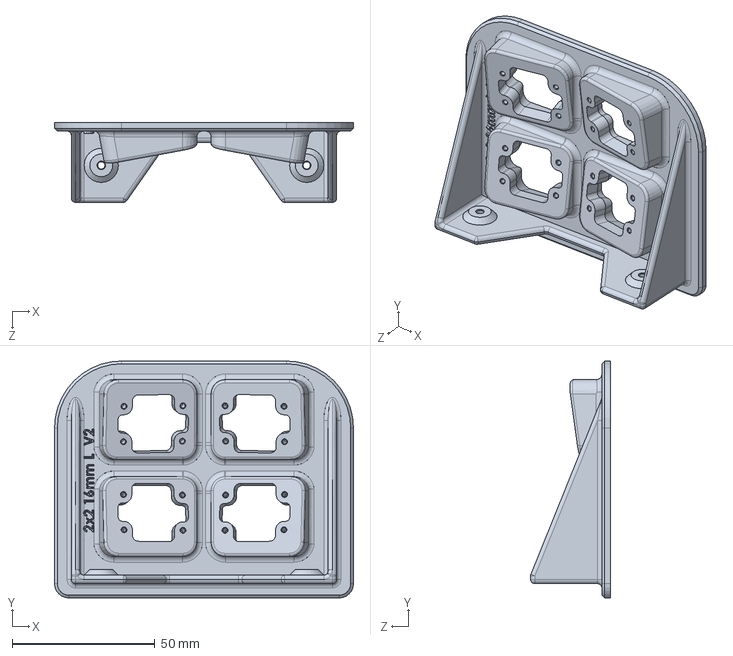
[picture p58: CAD file, 2023-07-29]
CAD/pi_cam/camera_mount_2x2_landscape_16mm_al.SLDPRT
104.8 x 83.0 x 28.0 mm
