CMU-CREATE-Lab/breathecam_v4/CAD/pi_cam/testing/OM_lens_mount.SLDPRT

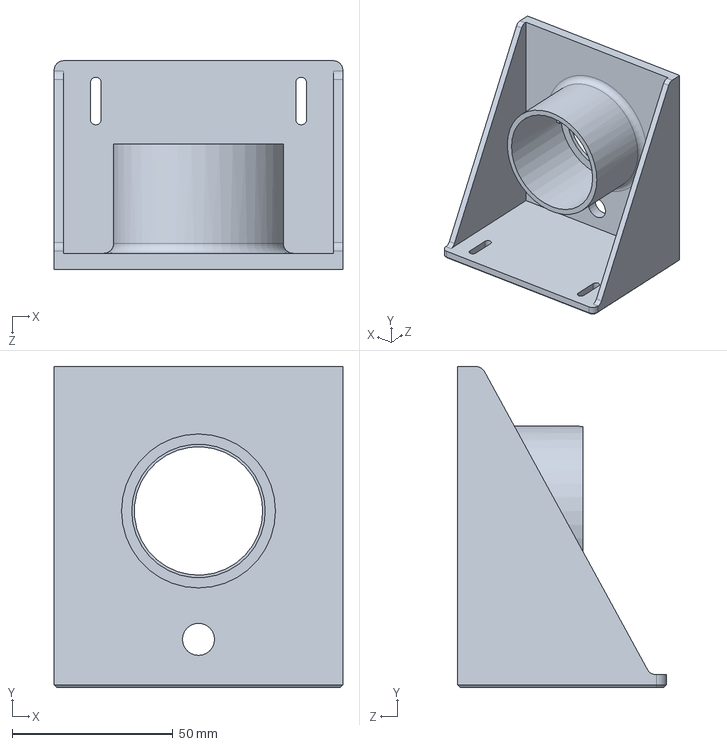
[picture p59: CAD file, 2023-06-16]
CAD/pi_cam/testing/OM_lens_mount.SLDPRT
90.0 x 100.0 x 65.0 mm
