CMU-CREATE-Lab/breathecam_v4/CAD/pi_cam/camera_mount_4x1_landscape_25mm.SLDPRT

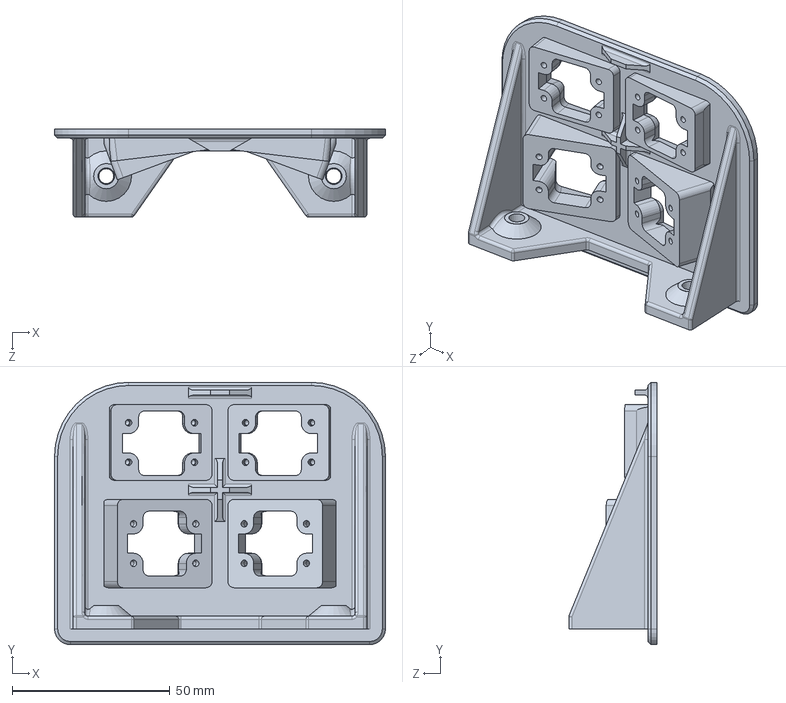
[picture p60: CAD file, 2023-01-09]
CAD/pi_cam/camera_mount_4x1_landscape_25mm.SLDPRT
104.8 x 83.0 x 28.0 mm
