CMU-CREATE-Lab/breathecam_v4/CAD/pi_cam/camera_mount_2x2_landscape_16mm.SLDPRT

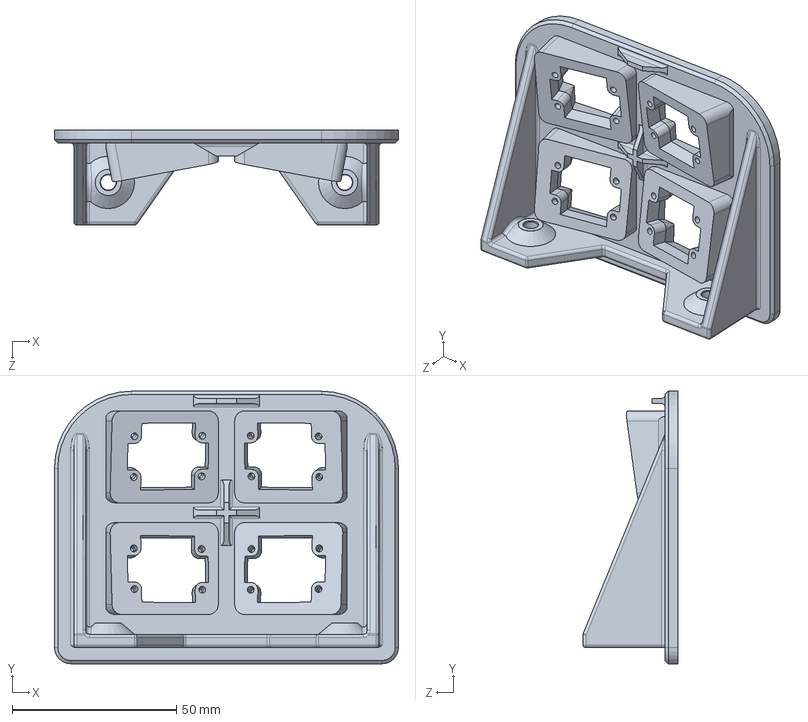
[picture p61: CAD file, 2023-01-09]
CAD/pi_cam/camera_mount_2x2_landscape_16mm.SLDPRT
104.8 x 83.0 x 29.0 mm
