CMU-CREATE-Lab/breathecam_v4/CAD/pi_cam/camera_mount_hq.SLDPRT

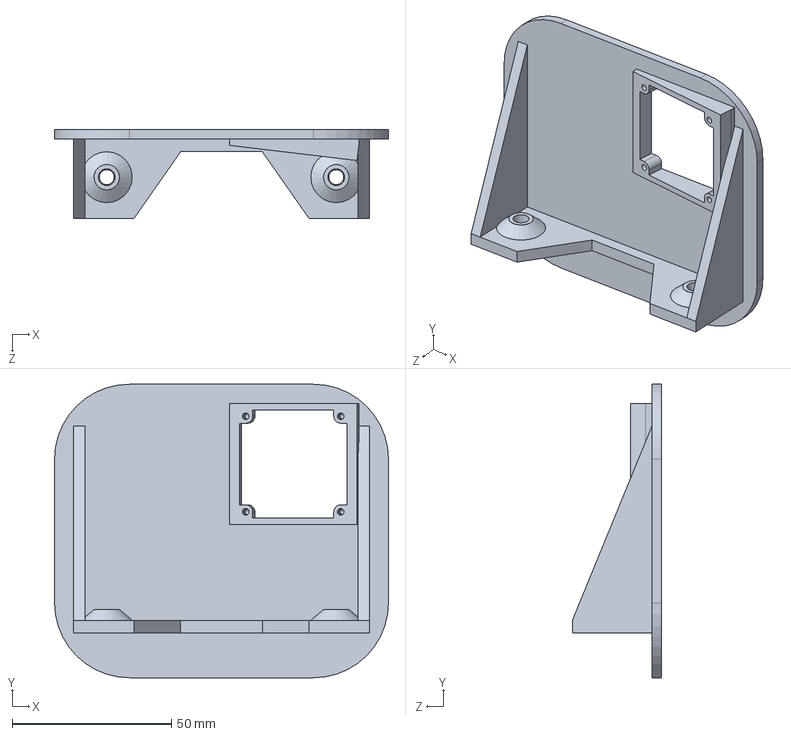
[picture p62: CAD file, 2022-12-06]
CAD/pi_cam/camera_mount_hq.SLDPRT
104.8 x 92.1 x 28.0 mm
