CMU-CREATE-Lab/breathecam_v4/CAD/pi_cam/flex_clip.SLDPRT

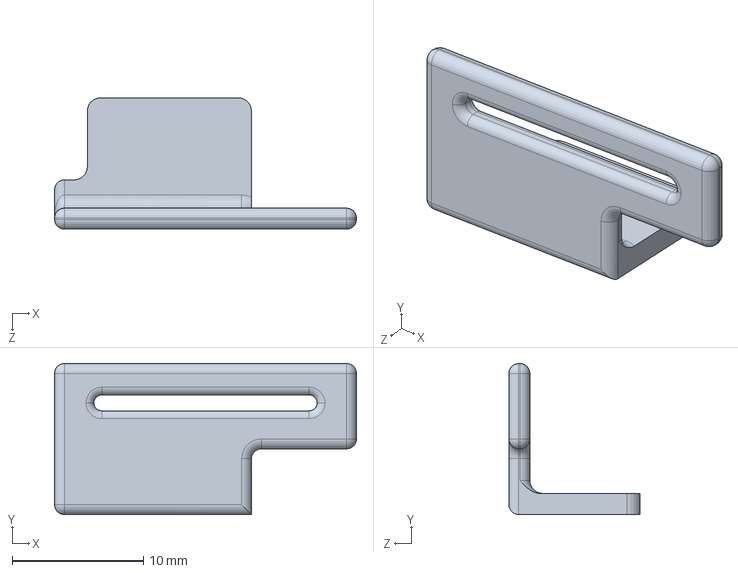
[picture p63: CAD file, 2022-12-06]
CAD/pi_cam/flex_clip.SLDPRT
23.0 x 11.5 x 10.0 mm
