CMU-CREATE-Lab/breathecam_v4/CAD/pi_cam/camera_mount_crosseyed.SLDPRT

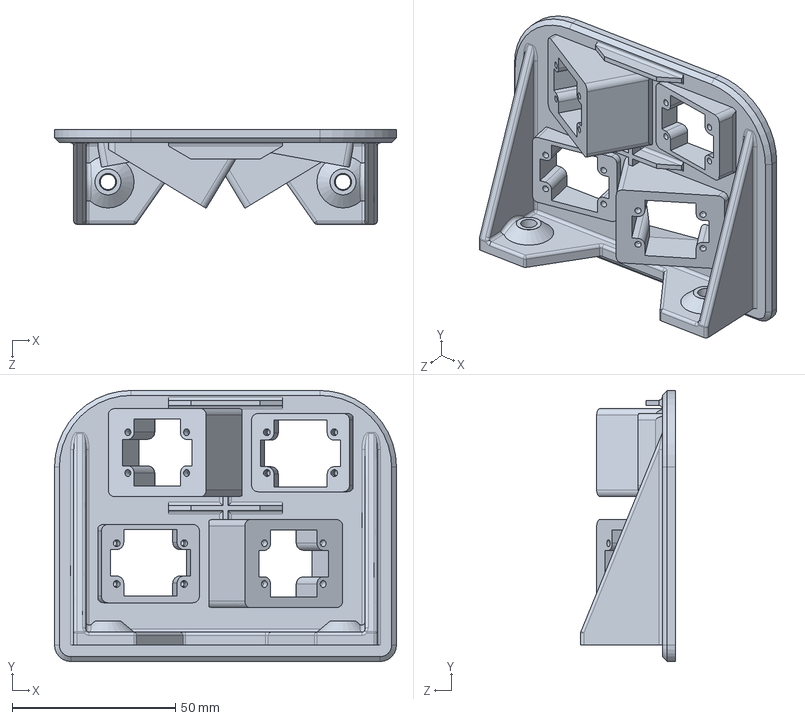
[picture p64: CAD file, 2022-10-27]
CAD/pi_cam/camera_mount_crosseyed.SLDPRT
104.8 x 83.0 x 29.0 mm
