CMU-CREATE-Lab/breathecam_v4/CAD/pi_cam/brackets/pole_clamp_assy.SLDASM

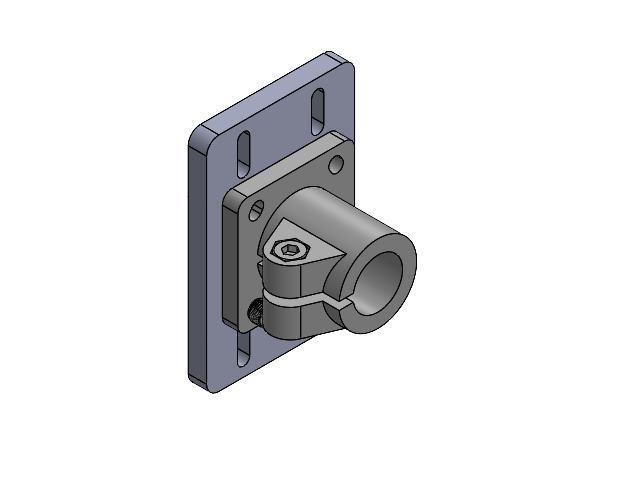
[picture p68: CAD file, 2024-04-23]
CAD/pi_cam/brackets/pole_clamp_assy.SLDASM
pole_clamp_plate
9578T61_Heavy Duty Aluminum Clamp-on Framing Fitting
96006A705_Black Oxide 18-8 Stainless Steel Socket Head Screw
