CMU-CREATE-Lab/breathecam_v4/CAD/pi_cam/camera_fasten_assy.SLDASM

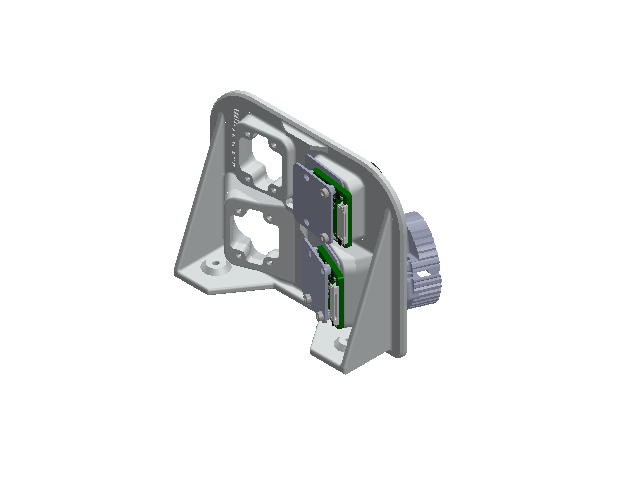
[picture p69: CAD file, 2024-10-29]
CAD/pi_cam/camera_fasten_assy.SLDASM
camera_mount_4x1_portrait_16mm_al_v4
UC-698(B0262) x 2
camera_cap_fat_clearance x 2
camera_insulator x 2
93705A804_18-8 Stainless Steel Thread-Locking Socket Head Screw(1) x 4
lockring_wrench
focus_adapter_14mm_small
