CMU-CREATE-Lab/breathecam_v4/CAD/pi_cam/testing/collimator_assem.SLDASM

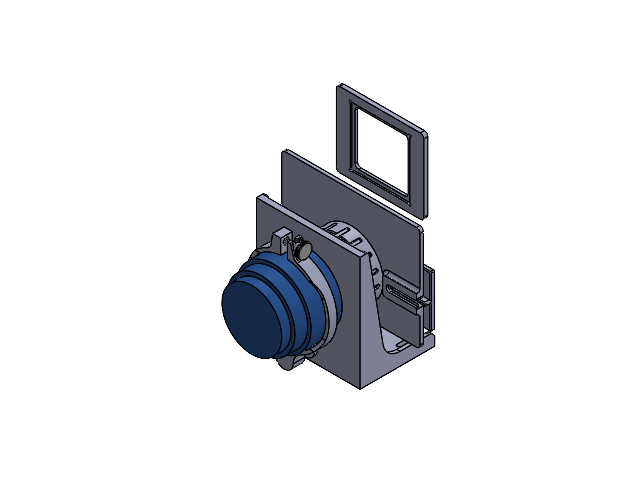
[picture p70: CAD file, 2023-11-29]
CAD/pi_cam/testing/collimator_assem.SLDASM
OM_lens_mount
target_mount
OM_lens_50mm
focus_lock
92558A340_Stainless Steel Raised Knurled-Head Thumb Screw
glass_holder_2in
glass_holder_3in
target_clamp
lens_lock
94180A323_Tapered Heat-Set Inserts for Plastic(1)
93038A116_Slotted Brass Flat-Tip Set Screw
