CMU-CREATE-Lab/breathecam_v4/(list of files, cad)

Other CAD files:
CAD/pi_cam/testing/focus_adapter_14mm.SLDPRT
CAD/pi_cam/angle_fix_4x1_16mm_p_top.STL
CAD/pi_cam/testing/OM_lens_50mm.SLDPRT
CAD/pi_cam/angle_fix_4x1.sldprt
CAD/pi_cam/testing/glass_holder.SLDPRT
CAD/pi_cam/camera_mount_4x1_portrait_25mm_al.SLDPRT
CAD/pi_cam/camera_mount_4x1_landscape_25mm_al.SLDPRT
CAD/pi_cam/air_box.STL
CAD/pi_cam/air_top.STL
CAD/pi_cam/angle_fix_4x1_16mm_p_bot.STL
CAD/pi_cam/brackets/pole_clamp_plate.SLDDRW
CAD/pi_cam/brackets/quick_connect_adapter.DXF
CAD/pi_cam/camera_cap_fat_clearance.STL
CAD/pi_cam/camera_insulator.DXF
CAD/pi_cam/camera_insulator.STL
CAD/pi_cam/camera_mount_2x2_landscape_16mm_al.STL
CAD/pi_cam/camera_mount_4x1_portrait_16mm_al.SLDPRT
CAD/pi_cam/camera_mount_4x1_portrait_16mm_al_v4.3mf
CAD/pi_cam/camera_mount_4x1_portrait_16mm_al_v4.STL
CAD/pi_cam/drill_guide.3mf
CAD/pi_cam/drill_guide.STL
CAD/pi_cam/dummy_parts/90278A725_18-8 Stainless Steel Precision Shoulder Screw.SLDPRT
CAD/pi_cam/dummy_parts/90368A102_18-8 Stainless Steel Knurled-Head Thumb Nut.SLDPRT
CAD/pi_cam/dummy_parts/93038A116_Slotted Brass Flat-Tip Set Screw.SLDPRT
CAD/pi_cam/dummy_parts/93625A102_18-8 Stainless Steel Nylon-Insert Locknut.SLDPRT
CAD/pi_cam/dummy_parts/93657A224_Nylon Unthreaded Spacer.SLDPRT
CAD/pi_cam/dummy_parts/93705A804_18-8 Stainless Steel Thread-Locking Socket Head Screw(1).SLDPRT
CAD/pi_cam/dummy_parts/93705A804_18-8 Stainless Steel Thread-Locking Socket Head Screw.SLDPRT
CAD/pi_cam/dummy_parts/93800A114_Nylon Hex Nut.SLDPRT
CAD/pi_cam/dummy_parts/94180A323_Tapered Heat-Set Inserts for Plastic(1).SLDPRT
CAD/pi_cam/dummy_parts/94180A323_Tapered Heat-Set Inserts for Plastic.SLDPRT
CAD/pi_cam/dummy_parts/94180A333_Tapered Heat-Set Inserts for Plastic(1).SLDPRT
CAD/pi_cam/dummy_parts/94180A333_Tapered Heat-Set Inserts for Plastic.SLDPRT
CAD/pi_cam/dummy_parts/95610A011_Nylon Plastic Washer.SLDPRT
CAD/pi_cam/dummy_parts/9578T61_Heavy Duty Aluminum Clamp-on Framing Fitting.SLDPRT
CAD/pi_cam/dummy_parts/96006A705_Black Oxide 18-8 Stainless Steel Socket Head Screw.SLDPRT
CAD/pi_cam/dummy_parts/Raspberry Pi HQ Camera.SLDPRT
CAD/pi_cam/flex_clip.STL
CAD/pi_cam/mount_plate_4pi.STL
CAD/pi_cam/mount_plate_single.3mf
CAD/pi_cam/mount_plate_single.STL
CAD/pi_cam/power_mount.STL
CAD/pi_cam/testing/OM_lens_mount.STL
CAD/pi_cam/testing/camera_retainer.STL
CAD/pi_cam/testing/focus_adapter_14mm.3mf
CAD/pi_cam/testing/focus_adapter_14mm.STL
CAD/pi_cam/testing/focus_adapter_clamp1.STL
CAD/pi_cam/testing/focus_adapter_clamp2.STL
CAD/pi_cam/testing/glass_clip.STL
CAD/pi_cam/testing/glass_holder.STL
CAD/pi_cam/testing/glass_holder_3in.STL
CAD/pi_cam/testing/lens_lock.3mf
CAD/pi_cam/testing/lens_lock.STL
CAD/pi_cam/testing/lens_threading_guide.STL
CAD/pi_cam/testing/lockring_wrench.3mf
CAD/pi_cam/testing/lockring_wrench.STL
CAD/pi_cam/testing/microscope_mount.STL
CAD/pi_cam/testing/om_lens_mount.3mf
CAD/pi_cam/testing/spacer_block.STL
CAD/pi_cam/testing/target_clamp.STL
CAD/pi_cam/testing/target_mount.STL
