CMU-CREATE-Lab/breathecam_v4/CAD/pi_cam/brackets/pole_clamp_plate.pdf

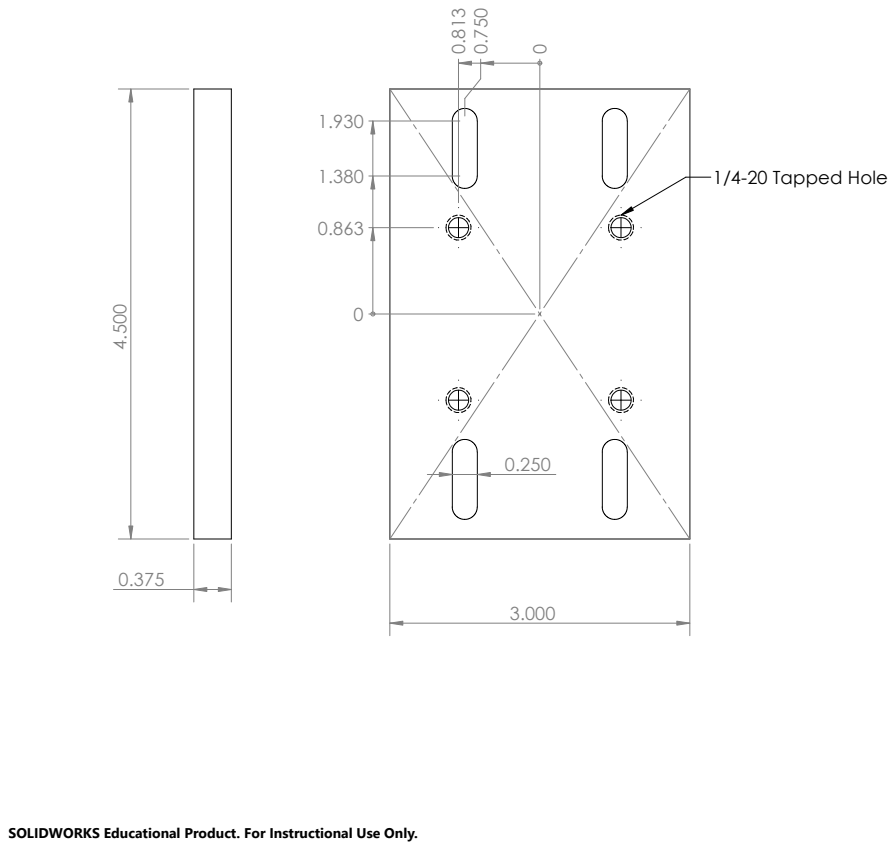
[picture p71: page 1]
1/4-20 Tapped Hole

SOLIDWORKS Educational Product. For Instructional Use Only.
