CMU-CREATE-Lab/breathecam_v4/(commit log)

2022-07-23 First commit, grabs single frame in auto-exposure mode
2022-07-23 Improve code readability
    Rename camera and stream config variables
2022-07-23 Report SENSOR_TIMESTAMP in epoch ms
2022-07-27 First release using new pi_cam_grab
    pi_cam_grab/grab now:
    - logs to file
    - writes backtraces on crash
    - honors --rotation
    imageService.py now:
    - knows how to call pi_cam_grab/grab if configured in breathecam.ini
    - uses json tuning file for longer low-light exposures
    [imageService.py]
2022-07-28 Use hostname for camera_id if blank in ini
2022-09-01 Merged some changes to mechanical CAD from my old repo.
    [camera_mount.SLDPRT, mount_plate_4pi.SLDPRT, power_mount.SLDPRT]
2022-09-03 Updates to Solidworks CAD for new 4pi build. All the files are also gratuitously modified due to change to Solidworks 2022. Deleted some obsolete parts. Adjusted slots in air_box.SLDPRT to manage air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
    [90368A102_18-8 Stainless Steel Knurled-Head Thumb Nut.SLDPRT, 93625A102_18-8 Stainless Steel Nylon-Insert Locknut.SLDPRT, 93657A224_Nylon Unthreaded Spacer.SLDPRT, 93800A114_Nylon Hex Nut.SLDPRT, 94180A333_Tapered Heat-Set Inserts for Plastic.SLDPRT, 95610A011_Nylon Plastic Washer.SLDPRT, Raspberry Pi 4 Model B.SLDASM, air_box.SLDPRT]
2022-09-06 Mechanical CAD changes: rearrange power_mount.SLDPRT terminal strip, changes to air_top.SLDPRT to make it less delicate in the PETG print. Deleted old angle_bracket.SLDPRT.
    [air_top.SLDPRT, angle_bracket.SLDPRT, fan_assy.SLDASM, power_mount.SLDPRT]
2022-09-12 Mechanical modifications for 4 pi build. Change fan clips to work with thinner 4.13mm OD spacer. power_mount.SLDPRT now has three-terminal strip so we can consistently terminate all three power wires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
    [air_box.SLDPRT, air_top.SLDPRT, fan_assy.SLDASM, power_mount.SLDPRT]
2022-09-14 Fixes to power_mount.SLDPRT for fit, screw bosses and foot did not agree on height. Added a bit more clearance between the back of the power mount and the housing.
    [air_box.SLDPRT, fan_assy.SLDASM, power_mount.SLDPRT]
2022-09-16 pi_cam: reenable start on reboot
    [install.py]
2022-09-16 pi_cam install: fix first time install of zerotier
    [install.py]
2022-09-23 Web console streams current jpeg in real time
2022-09-25 Performance improvements; handle window resize
    Changed to raw stream for showing image updates.
    Handle ROI correctly for window resizes and image size changes
    [webConsole.py]
2022-10-19 Updated webConsole
    install.py installs correct version of flask:
    Installs flask>=2.2 with pip
    Uninstalls python3-flask package (1.x) if present
    Add flask webConsole to run_all,.sh/kill_all.sh
    [install.py]
2022-10-19 Bugfix: pi_cam install flask >=2.2 properly
    [install.py]
2022-10-27 Work on camera mount for 16mm lenses (wider angle). quad_angles.m finds the camera angle offsets, camera_mount_crosseyed.SLDPRT is the new mount.
    [camera_mount_crosseyed.SLDPRT]
2022-11-08 pi_cam installer can cope with newer kernels
    pi_cam install.py:
    - adds dtoverlay=imx477 to /boot/config.txt
    for kernels that can't autodetect properly
    - will reboot if kernel updated or config.txt changed
    [install.py]
2022-11-08 pi_cam install: fully install even when needing reboot
    [install.py]
2022-11-21 New part CAD/pi_cam/flex_clip.SLDPRT guides camera flex away from the pi circuit boards to reduce potential for interference.
    [flex_clip.SLDPRT]
2022-12-19 pi_cam: fix test-only image capture
    [imageService.py, serviceConfig.py]
2023-01-09 New camera_mount_2x2_portrait.SLDPRT Updated camera_mount.SLDPRT to make walls thicker for SLS print Generalized quad_angles.m to handle 2D camera arrangements and compute the FOV from focal length.
    [camera_mount.SLDPRT, camera_mount_2x2_portrait.SLDPRT]
2023-01-13 Removed a bunch of old stuff from README.md, changed default image "interval" to 3 sec/frame
2023-02-08 Minor tweaks to camera_mount_assy_4pi.SLDASM to try get the rod nut position to line up with the as-built assembly. Fixed the length of m25_long_rod.SLDPRT, but the position of the boards is wrong fo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
    [Raspberry Pi HQ Camera.SLDPRT, Raspberry Pi HQ Camera.step, m25_long_rod.SLDPRT]
2023-02-16 camera_mount_4x125mm_al.SLDPRT is tweaked according to aluminum design guides, and for tapped holes. Deleted old mount_plate.SLDPRT.
    [camera_mount_4x125mm_al.SLDPRT, mount_plate.SLDPRT, mount_plate_4pi.SLDPRT]
2023-02-16 Added drill_guide.SLDPRT for drill and tap of camera_mount_4x125mm_al.SLDPRT
    [camera_mount_4x125mm_al.SLDPRT, drill_guide.SLDPRT]
2023-03-03 Tweak drill_guide.SLDPRT for fit
    [drill_guide.SLDPRT]
2023-03-17 New camera mount for 16mm: camera_mount_4x1_16mm_al.SLDPRT
    [camera_mount_4x1_16mm_al.SLDPRT]
2023-03-29 Renamed the various camera_mount parts to be consistent across variants. Added camera_mount_2x2_landscape_16mm_al.SLDPRT
    [camera_mount_2x2_landscape_16mm.SLDPRT, camera_mount_2x2_landscape_16mm_al.SLDPRT, camera_mount_4x125mm_al.SLDPRT, camera_mount_4x1_16mm_al.SLDPRT, camera_mount_4x1_landscape_25mm.SLDPRT, camera_mount_4x1_landscape_25mm_al.SLDPRT, camera_mount_4x1_portrait_16mm_al.SLDPRT]
2023-04-11 Code cleanups and start on administration tools.
    Deleted obsolete files: ArducamMux.py boot_config.txt
    Moved to tools/ directory:
    count-corrupt.ipynb
    install.py
    kill_all.sh
    update.py
    run_all.sh:
    Changed to not actually run if the file "config_files/run_inhibit" exists.
    This lets us hold off on running the services (and the watchdog behavior)
    until the host is actually fully initialized.
    tools/zerotier_join.py:
    split off from install.py so that we can delay this to after sd card cloning.
    tools/run_quad:
    utility for running a command on the "a, b, c, d" hosts.
    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
    [boot_config.txt]
2023-04-12 Fixes to paths for relocating to tools directory
    [install.py]
2023-04-12 Now more fixed than ever before for relocating to tools directory
    [install.py]
2023-04-12 New camera_mount_4x1_portrait_25mm_al.SLDPRT. Deleted terminal strip from power_mount.SLDPRT now that we connect directly from the cord pigtail to the supply cord. Updates to README.md describing SD 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
    [camera_mount_4x1_portrait_25mm_al.SLDPRT, power_mount.SLDPRT]
2023-05-03 Added design for two camera pole mount.
    [drill_guide.SLDPRT, dual_mount_horizontal_tube.SLDPRT, dual_mount_vertical_tube.SLDPRT, pelco_eh20_external.SLDPRT, pole_18in.SLDPRT]
2023-06-01 More work on the double mount bracket
    [pole_mount_spacer.SLDPRT, quick_connect_adapter.SLDPRT]
2023-06-16 Add CAD/pi_cam/testing/ with collimator camera tester fixture. Add camera_cap.SLDPRT to replace insulating spacers on camera back. Add camera_fasten_assy.SLDASM to model camera board mounting. Revise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
    [OM_lens_50mm.SLDPRT, OM_lens_mount.SLDPRT, camera_cap.SLDPRT, camera_fasten_assy.SLDASM, camera_mount_4x1_portrait_16mm_al.SLDPRT, centering_adapter_14mm.SLDPRT, collimator_assem.SLDASM, focus_lock.SLDPRT]
2023-06-22 Work on test collimator CAD.
    [collimator_assem.SLDASM, focus_lock.SLDPRT, glass_clip.SLDPRT, glass_holder.SLDPRT, microscope_mount.SLDPRT, target_mount.SLDPRT]
2023-06-27 Tweaks to camera_cap to get it to print in PETG, added clearance for tightest components. Added label with design and version to the 4x1 portrait camera mounts, adjusted pointing angles for the new 2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
    [camera_cap.SLDPRT, camera_cap_fat_clearance.SLDPRT, camera_fasten_assy.SLDASM, camera_mount_4x1_portrait_16mm_al.SLDPRT, camera_mount_4x1_portrait_25mm_al.SLDPRT, centering_adapter_14mm.SLDPRT]
2023-07-29 Eh, changed something in camera_mount_2x2_landscape_16mm_al.SLDPRT and camera_mount_4x1_portrait_16mm_al.SLDPRT? And check in some pole clamp stuff.
    [9578T61_Heavy Duty Aluminum Clamp-on Framing Fitting.SLDPRT, 96006A705_Black Oxide 18-8 Stainless Steel Socket Head Screw.SLDPRT, camera_mount_2x2_landscape_16mm_al.SLDPRT, camera_mount_4x1_portrait_16mm_al.SLDPRT, pole_clamp_assy.SLDASM, pole_clamp_plate.SLDDRW, pole_clamp_plate.SLDPRT]
2023-08-04 Angle fixtures for machining camera mounts
    [angle_fix_4x1.sldprt, angle_fix_4x1_16mm_p_bot.STL, angle_fix_4x1_16mm_p_top.STL, angle_fix_4x1_25mm_p_bot.STL, angle_fix_4x1_25mm_p_top.STL, angle_fix_assy.SLDASM, camera_mount_4x1_portrait_16mm_al.SLDPRT, camera_mount_4x1_portrait_25mm_al.SLDPRT]
2023-08-12 Add single camera mount_plate_single.SLDPRT, test_mount.SLDPRT, and also camera_insulator.SLDPRT. Change camera_fasten_assy.SLDASM to use camera_insulator.SLDPRT instead of washers.
    [94180A323_Tapered Heat-Set Inserts for Plastic.SLDPRT, camera_cap_fat_clearance.SLDPRT, camera_fasten_assy.SLDASM, camera_insulator.SLDPRT, mount_plate_single.SLDPRT, test_mount.SLDPRT]
2023-08-14 More fiddling with the single camera setup. Renamed test_mount.SLDPRT to camera_mount_single_portrait.SLDPRT for consistency with the other camera mounts.
    [camera_mount_single_portrait.SLDPRT, mount_plate_single.SLDPRT, test_mount.SLDPRT]
2023-09-21 Updates to README and configuration scripts
    [94180A333_Tapered Heat-Set Inserts for Plastic(1).SLDPRT]
2023-10-24 imageService: Allow 90 and 270 degree camera rotations
2023-10-27 Some actual modifications in CAD/pi_cam, and also update to latest Solidworks version, which changed everything. Fixed camera_mount_assy_4pi.SLDASM which had gotten broken. Now it refers to camera_fa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
    [90368A102_18-8 Stainless Steel Knurled-Head Thumb Nut.SLDPRT, 93625A102_18-8 Stainless Steel Nylon-Insert Locknut.SLDPRT, 93657A224_Nylon Unthreaded Spacer.SLDPRT, 93800A114_Nylon Hex Nut.SLDPRT, Raspberry Pi 4 Model B.SLDASM, air_box.SLDPRT, air_top.SLDPRT, angle_fix_4x1.sldprt]
2023-11-01 Work on test camera mount and drill guide
    [camera_mount_single_landscape.SLDPRT, camera_mount_single_portrait.SLDPRT, camera_mount_test.SLDPRT, drill_guide.SLDPRT, glass_holder.SLDPRT]
2023-11-29 A bunch of changes and new parts related to the collimator test rig. I also added all the .STL files and .3mf files (Bambu labs projects).
    [93038A116_Slotted Brass Flat-Tip Set Screw.SLDPRT, 94180A323_Tapered Heat-Set Inserts for Plastic(1).SLDPRT, 94180A323_Tapered Heat-Set Inserts for Plastic.SLDPRT, OM_lens_50mm.SLDPRT, OM_lens_mount.STL, air_box.STL, air_top.STL, angle_fix_4x1_16mm_p_bot.3mf]
2023-12-06 Tweaks to camera_mount_test.SLDPRT and added target_guide.SLDPRT to give a precise register for the resolution test target.
    [camera_mount_test.SLDPRT, target_guide.SLDPRT]
2023-12-20 Make pi_camera work with older installation (i.e. clairton)
    - Fix accidental use of python 3.10 type syntax to be compatible with python 3.9
    - Make new breathecam.ini fields for security cam relay be optional
    - Increase reboot delay to 60 secs from 30 secs
    [imageService.py, serviceConfig.py]
2024-01-23 Changes to focus_adapter_14mm to move the locking screw to the side and position the camera lens as close as possible to the collimator lens, since the distance was contributing to light dropoff and 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
    [camera_insulator.DXF, camera_mount_4x1_portrait_12mm_al.SLDPRT, camera_retainer.SLDPRT, focus_adapter_14mm.3mf, focus_adapter_14mm.SLDPRT, focus_adapter_14mm.STL, focus_adapter_14mm_assem.SLDASM, focus_adapter_clamp1.SLDPRT]
2024-02-20 Fix focal length to be 12.5mm, not 12, and increased the image overlap from 250 to 300 pixels.
2024-03-25 In quick_connect_adapter.SLDPRT removed countersinks so that we could more easily export as DXF for cutting services (sendcutsend).
    [quick_connect_adapter.DXF, quick_connect_adapter.SLDPRT]
2024-04-23 Add flat_mount_plate.SLDPRT for mounting on flat surface.
    [9578T61_Heavy Duty Aluminum Clamp-on Framing Fitting.SLDPRT, 96006A705_Black Oxide 18-8 Stainless Steel Socket Head Screw.SLDPRT, flat_mount_plate.SLDPRT, pole_clamp_assy.SLDASM, pole_clamp_plate.SLDPRT]
2024-06-25 Added pole_clamp_assem.SLDASM
    [9578T61_Heavy Duty Aluminum Clamp-on Framing Fitting.SLDPRT, pole_clamp_assem.SLDASM]
2024-06-26 Fast focus mode now kind of works. Main issue in imageService.py is that the implementation using ScalerCrop isn't actually fast if its high res and isn't high res if its fast. In the web interface w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
    [imageService.py, scrollpos.py, webConsole.py]
2024-08-14 Tweaked lower cam on camera_mount_4x1_portrait_16mm_al_v4.SLDPRT to give better front clearance for lens adjustment. You can now reach the lens lockring.
    [93705A804_18-8 Stainless Steel Thread-Locking Socket Head Screw(1).SLDPRT, 93705A804_18-8 Stainless Steel Thread-Locking Socket Head Screw.SLDPRT, camera_cap_fat_clearance.SLDPRT, camera_fasten_assy.SLDASM, camera_mount_4x1_portrait_16mm_al_v4.SLDPRT, camera_mount_4x1_portrait_16mm_al_v4.STL, lockring_wrench.SLDPRT]
2024-08-15 Added focus_adapter_14mm_small.SLDPRT which can be clamped onto the lens for focusing in the field, when camera is installed in camera_mount_4x1_portrait_16mm_al_v4.sldprt
    [camera_fasten_assy.SLDASM, camera_mount_4x1_portrait_16mm_al_v4.3mf, focus_adapter_14mm_small.SLDPRT]
2024-08-20 Added test_mount_plate.SLDPRT and related files, for testing full camera innards when not in the enclosure, to make focus adjustments possible.
    [90278A725_18-8 Stainless Steel Precision Shoulder Screw.SLDPRT, Raspberry Pi 4 Model B.SLDASM, camera_fasten_assy.SLDASM, camera_mount_4x1_portrait_16mm_al_v4.SLDPRT, camera_mount_4x1_portrait_16mm_al_v4.STL, focus_adapter_14mm_small.SLDPRT, test_mount_plate.SLDPRT, test_mount_plate_clamp.SLDPRT]
2024-09-10 Added test_mount_plate_assem.SLDASM and related parts, this is used for testing the full camera setup mounted outside of the enclosure, so that cameras can be focused, such as in the field. Added mou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
    [camera_mount_4x1_portrait_16mm_al_v4.3mf, test_mount_plate.SLDPRT, test_mount_plate_clamp.SLDPRT]
2024-09-24 Added 15 minute gunicorn worker timeout so that streaming isn't cut too short. Was 30 sec.
2025-01-06 Semi-gratuitous change from chatgpt to use Path instead of os.path in install.py config.txt has moved. fixed add_line_to_config to acutually work moved testing code from install.py to tools/test.sh, 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
    [imageService.py, install.py, webConsole.py]
2025-05-06 Tweaks to README
    [mount_plate_single.3mf]
2025-06-20 Added tools/wait_for_ntp.py which does a quick test for having time, rather than waiting for full NTP convergence. This replaces the code in serviceConfig.py which was polling ntpstat. Added document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
    [serviceConfig.py]
2025-06-24 Changes related to logging. Rotate and prune logs to prevent unbounded growth. Change some logs from INFO to DEBUG. If scrollpos.json doesn't exist, don't log anything.
    [imageService.py, scrollpos.py, serviceConfig.py]
2025-08-26 Mostly changes to README.md related to NTP configuration and using a windows laptop with network sharing for field access to the Pi hosts.
    [flat_mount_plate_24in.SLDPRT]
2026-09-17 Added various mount plates for single HQ camera.
    [CIL100-F3.6-M12ANIR.stp, Raspberry Pi 4 Model B.SLDASM, Raspberry Pi HQ Camera.SLDPRT, assembly_hq_single.SLDASM, assembly_hq_single_long.SLDASM, camera_mount_hq_single.SLDPRT, mount_plate_single.3mf, mount_plate_single.SLDPRT]
